hoangwe/Computation-design-fabrication-and-control-of-a-Two-wheel-Balancing-Robot./imgs/Circuit-diagram-of-two-wheel-self-balancing-robot-696x381.jpg

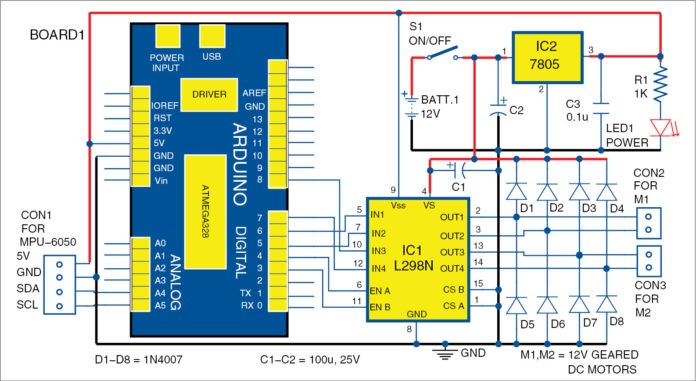
imgs/Circuit-diagram-of-two-wheel-self-balancing-robot-696x381.jpg
