hoangwe/Computation-design-fabrication-and-control-of-a-Two-wheel-Balancing-Robot./imgs/z3968502732451_e49155647b118cd0371b57f4b867cec1.jpg

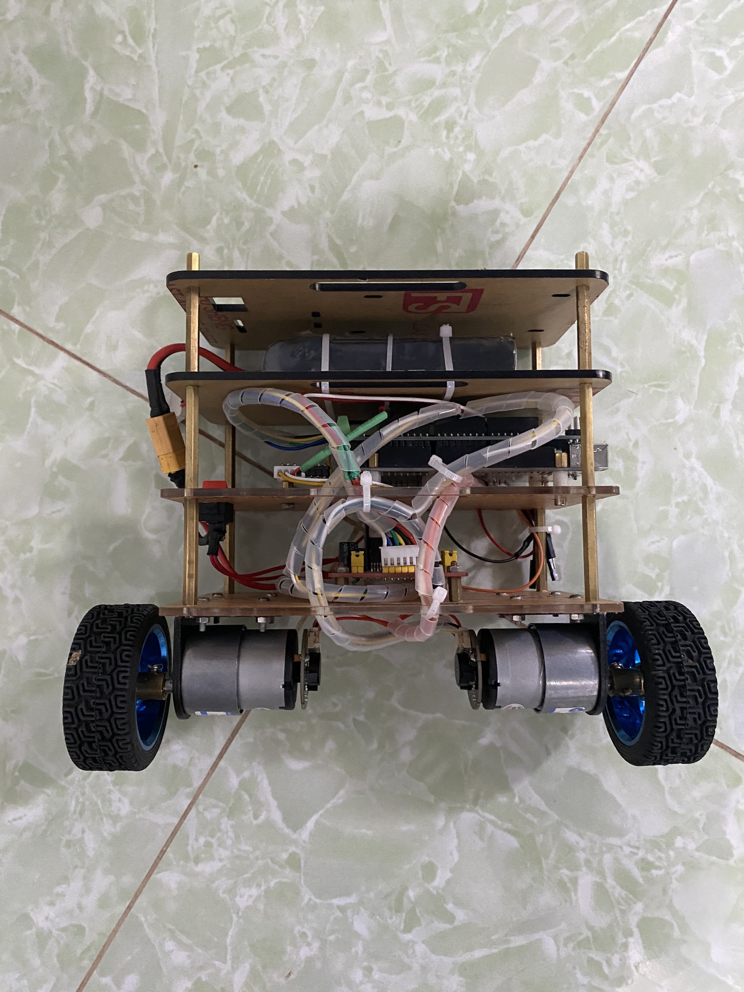
imgs/z3968502732451_e49155647b118cd0371b57f4b867cec1.jpg
