hoangwe/Computation-design-fabrication-and-control-of-a-Two-wheel-Balancing-Robot./README.md

# Computation-design-fabrication-and-control-of-a-Two-wheel-Balancing-Robot.
In this project, the system is developed for balancing and moving to the specified position. Real-time monitored and controlled system including GUI for observation, trajectory planning, and control quality assessment.
