hoangwe/Computation-design-fabrication-and-control-of-a-Two-wheel-Balancing-Robot./configurable-rc-coupling-1.snapshot.7/RC coupling - Camera 2 - Brass - 3 Point faded.JPG

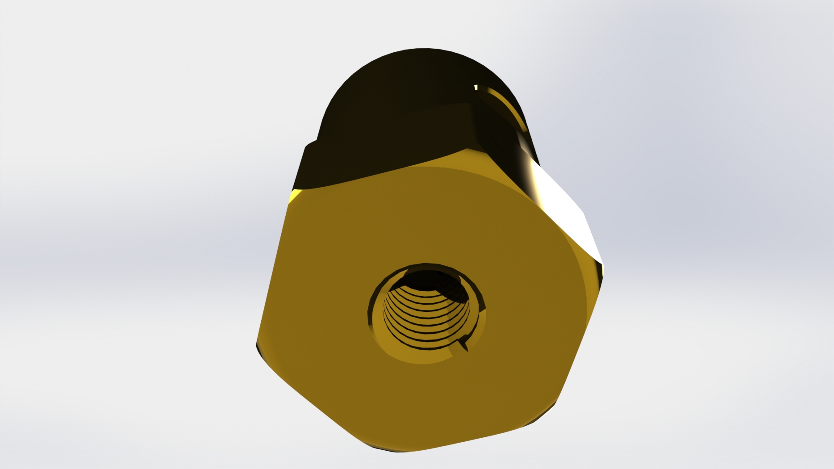
configurable-rc-coupling-1.snapshot.7/RC coupling - Camera 2 - Brass - 3 Point faded.JPG
