hoangwe/Computation-design-fabrication-and-control-of-a-Two-wheel-Balancing-Robot./imgs/anim2.gif

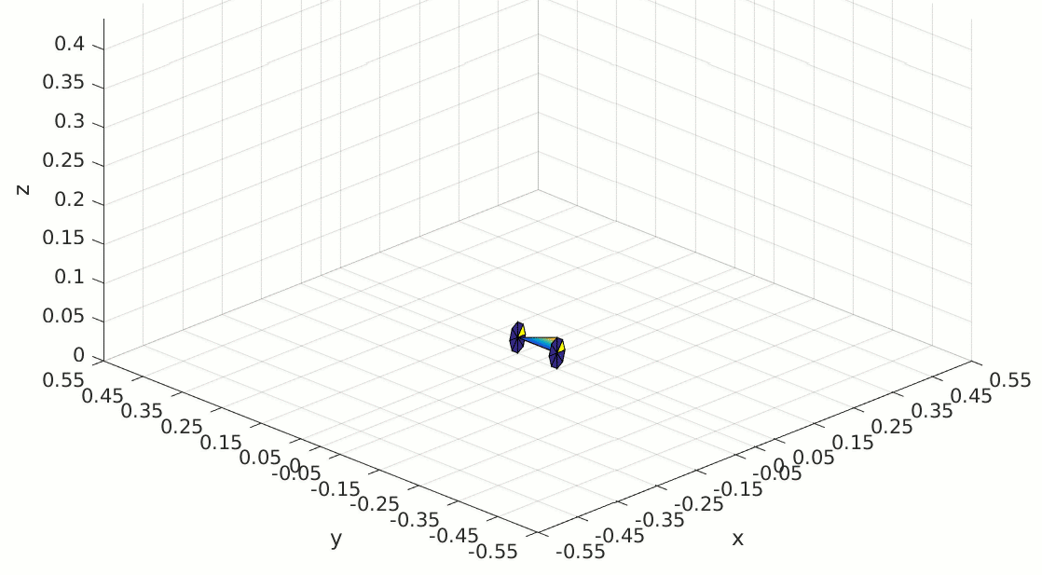
imgs/anim2.gif
