hoangwe/Computation-design-fabrication-and-control-of-a-Two-wheel-Balancing-Robot./imgs/BalanceCarRobot_PCB-V06_01.jpg

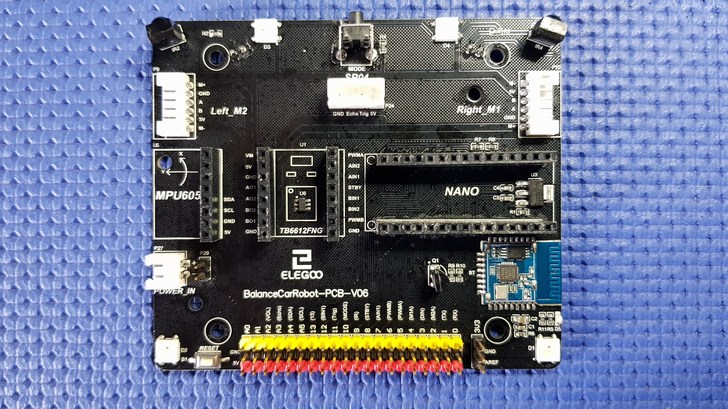
imgs/BalanceCarRobot_PCB-V06_01.jpg
