hoangwe/Computation-design-fabrication-and-control-of-a-Two-wheel-Balancing-Robot./imgs/plot1.png

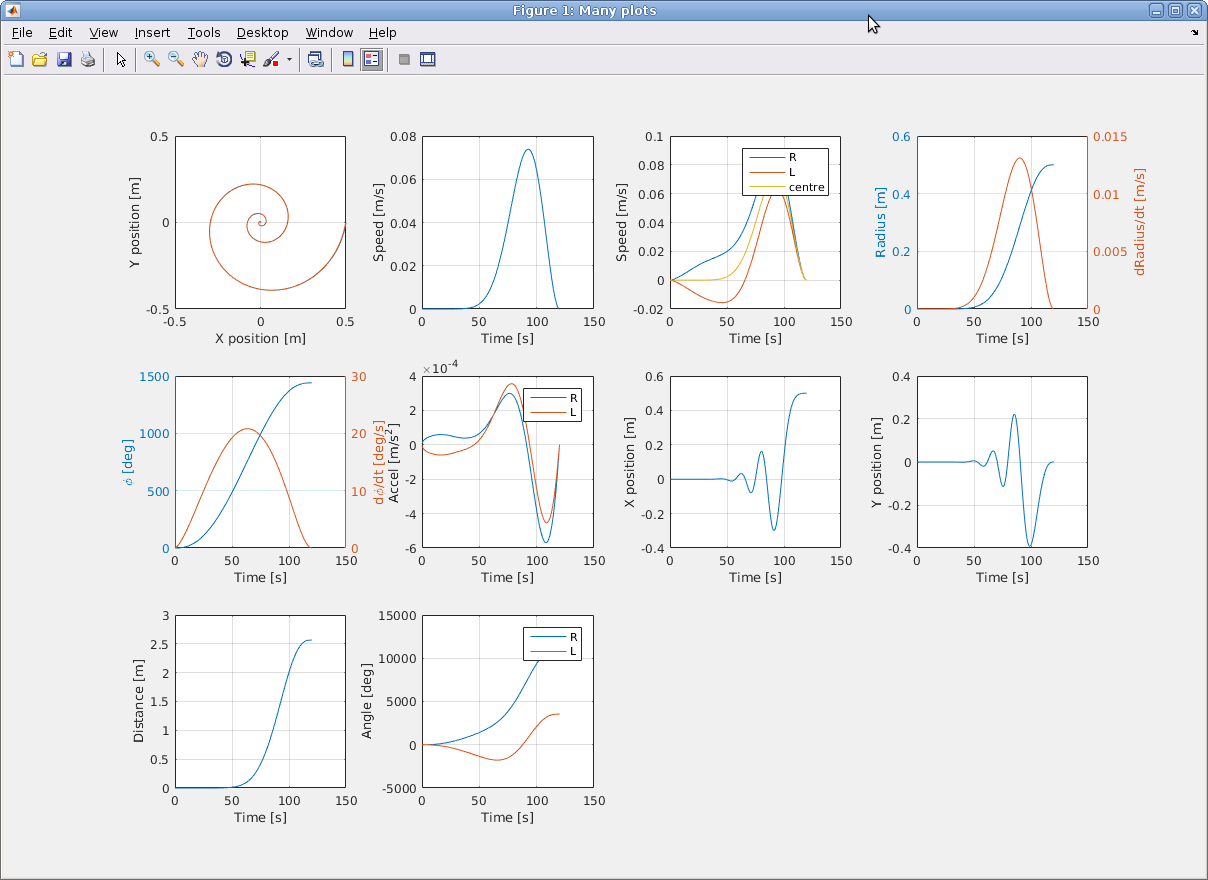
imgs/plot1.png
