hoangwe/Computation-design-fabrication-and-control-of-a-Two-wheel-Balancing-Robot./New folder/e_drawing/electric-images/0001.jpg

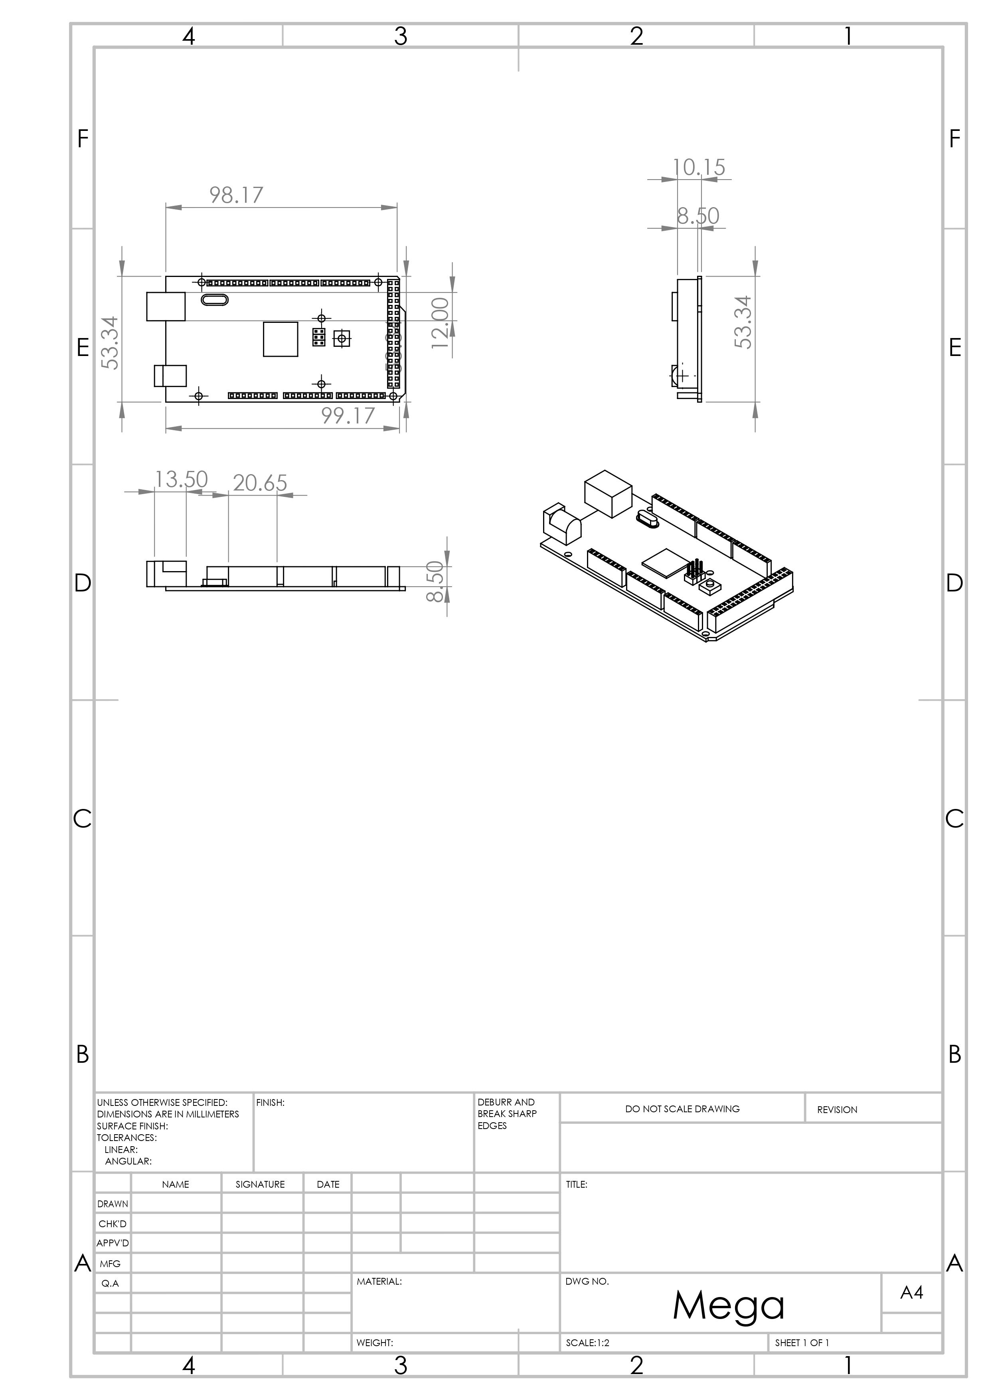
New folder/e_drawing/electric-images/0001.jpg
