hoangwe/Computation-design-fabrication-and-control-of-a-Two-wheel-Balancing-Robot./New folder/New folder/encoder.jpg

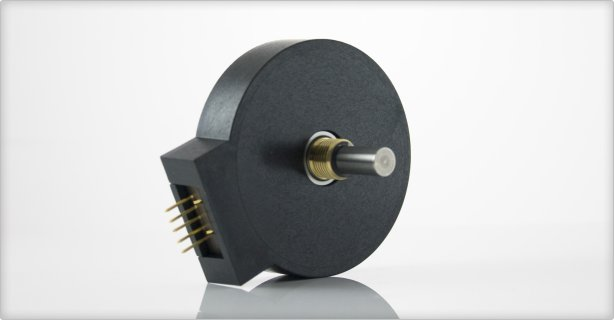
New folder/New folder/encoder.jpg
