hoangwe/Computation-design-fabrication-and-control-of-a-Two-wheel-Balancing-Robot./New folder/New folder/L298N_v2-removebg-preview.png

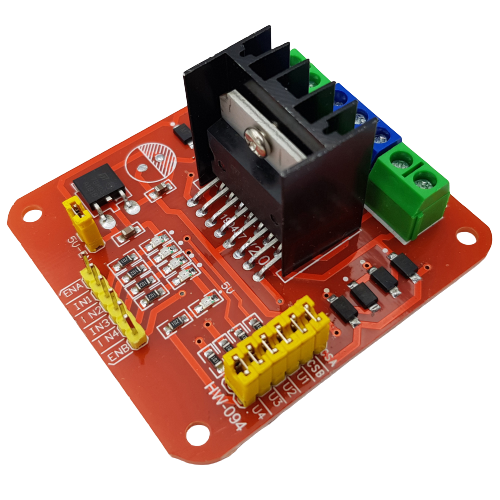
New folder/New folder/L298N_v2-removebg-preview.png
