hoangwe/Computation-design-fabrication-and-control-of-a-Two-wheel-Balancing-Robot./New folder/New folder/Mo_hinh.JPG

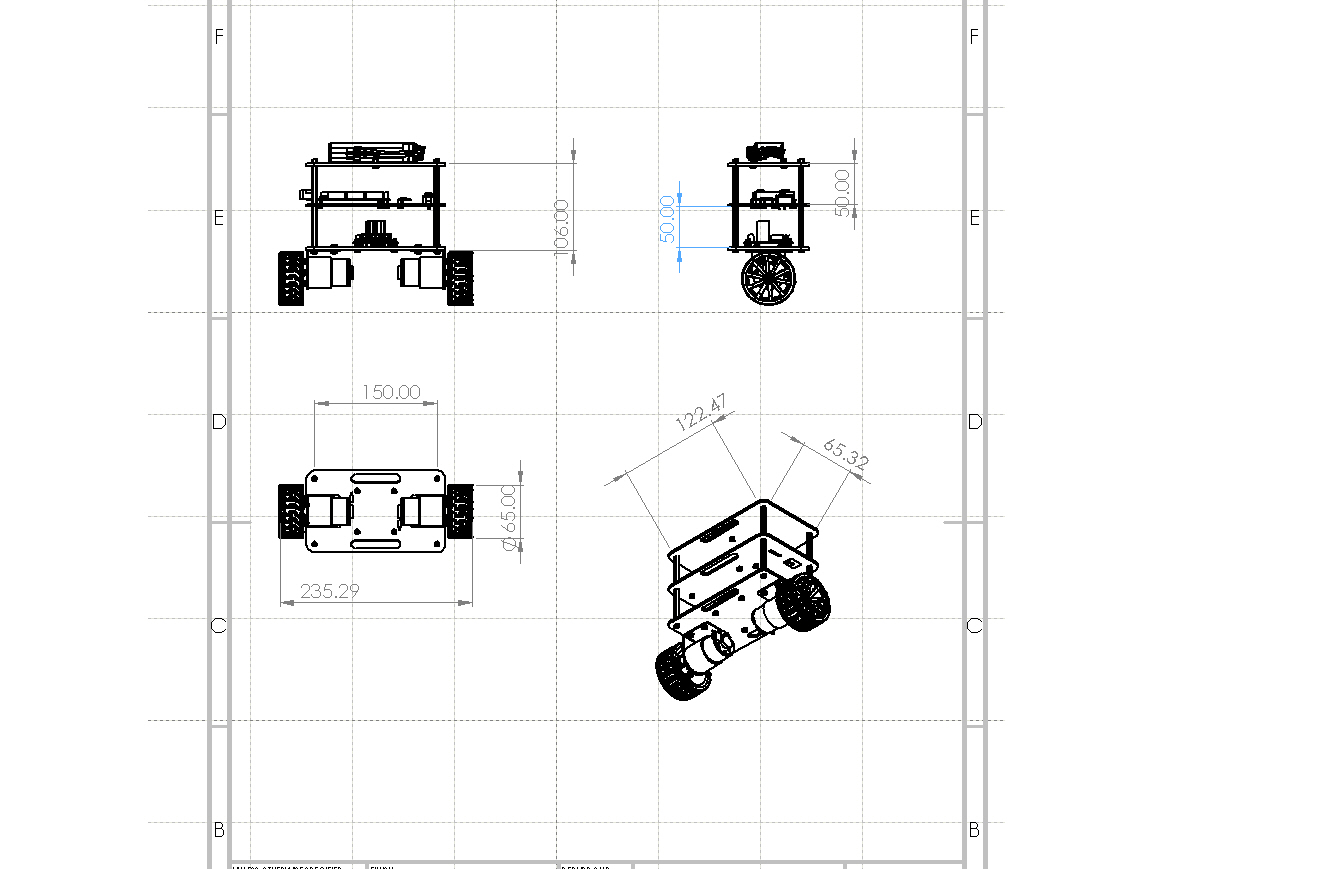
New folder/New folder/Mo_hinh.JPG
