hoangwe/Computation-design-fabrication-and-control-of-a-Two-wheel-Balancing-Robot./New folder/New folder/mohinh.jpg

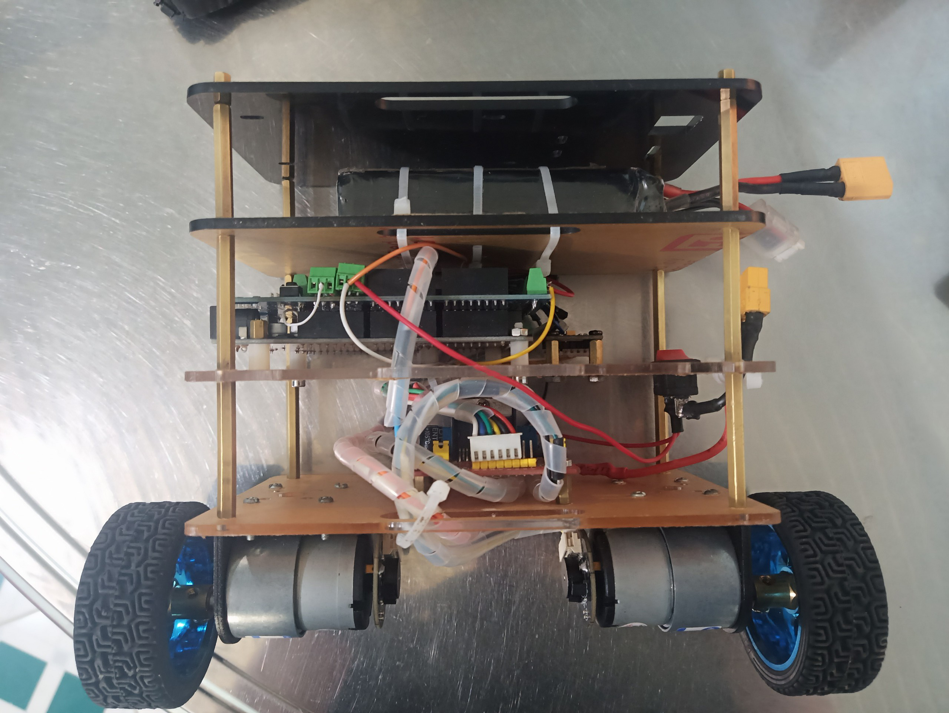
New folder/New folder/mohinh.jpg
