hoangwe/Computation-design-fabrication-and-control-of-a-Two-wheel-Balancing-Robot./New folder/New folder/mohinh_v2-removebg-preview.png

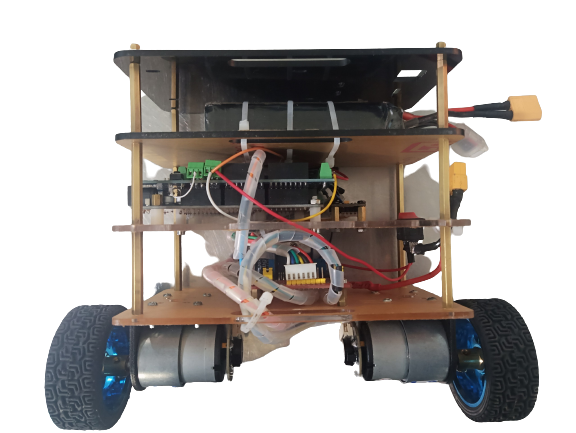
New folder/New folder/mohinh_v2-removebg-preview.png
