hoangwe/Computation-design-fabrication-and-control-of-a-Two-wheel-Balancing-Robot./New folder/New folder/New folder/New folder/file_dwg/37 mm DC Geared Motor Mounting Bracket.jpg

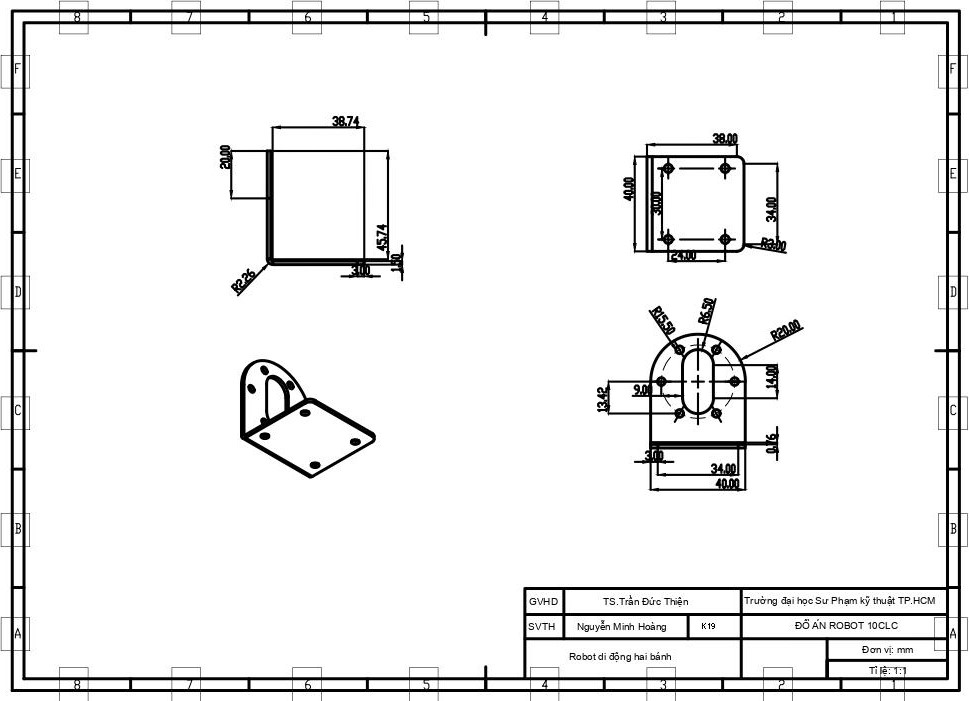
New folder/New folder/New folder/New folder/file_dwg/37 mm DC Geared Motor Mounting Bracket.jpg
