hoangwe/Computation-design-fabrication-and-control-of-a-Two-wheel-Balancing-Robot./New folder/New folder/New folder/New folder/file_dwg/Part0_loc.jpg

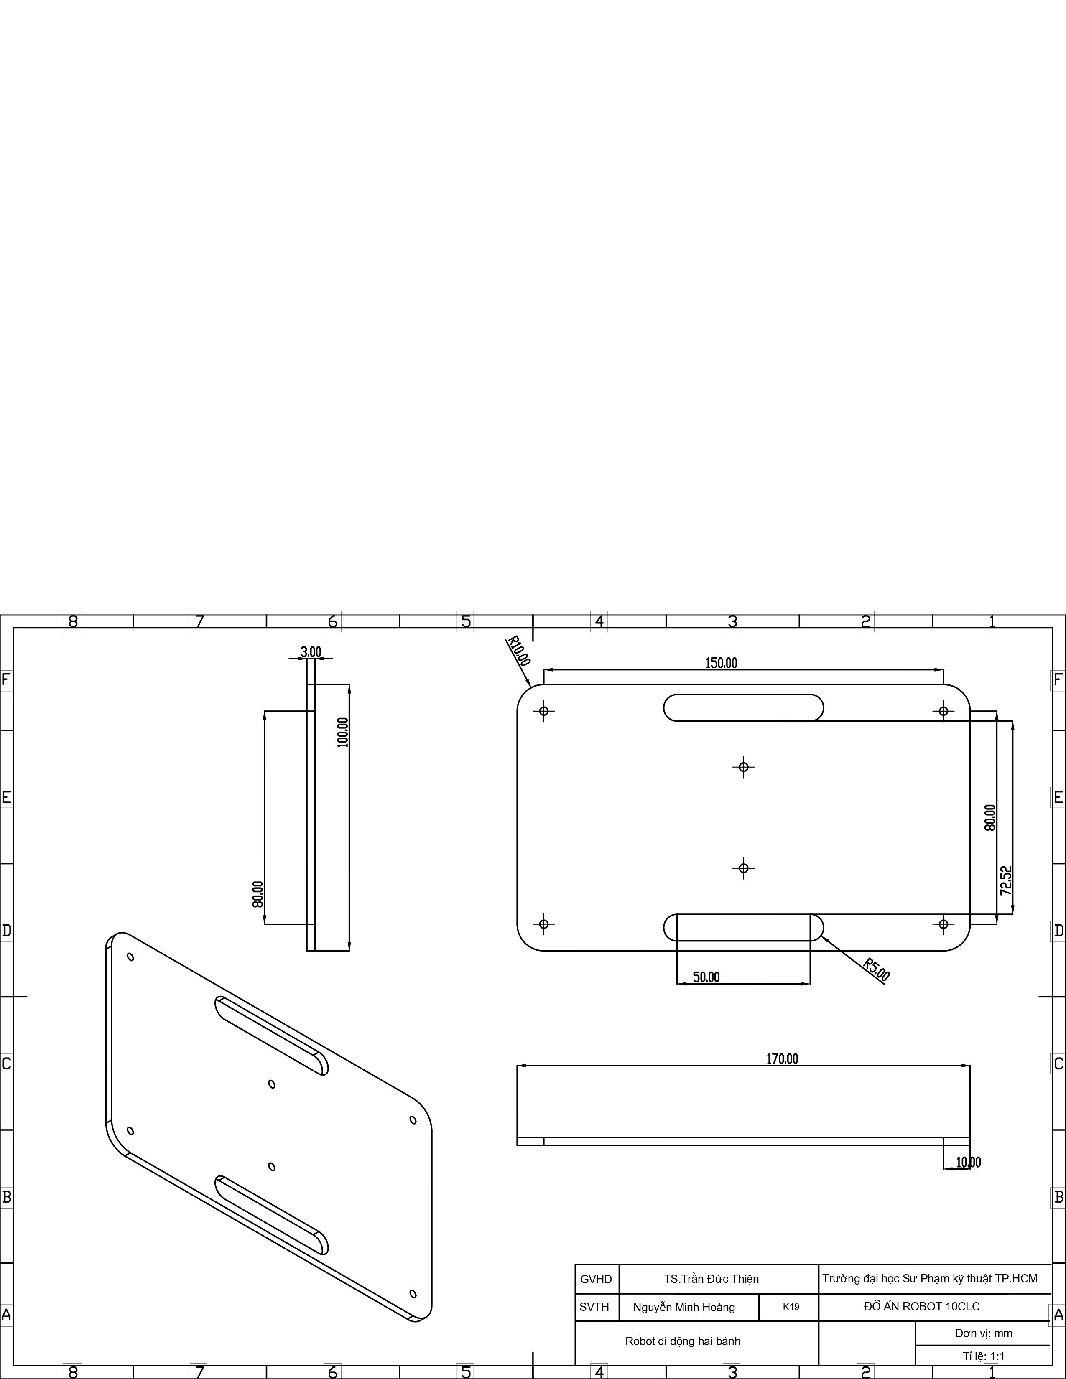
New folder/New folder/New folder/New folder/file_dwg/Part0_loc.jpg
