hoangwe/Computation-design-fabrication-and-control-of-a-Two-wheel-Balancing-Robot./New folder/New folder/New folder/New folder/file_dwg/Part3_loc_v2.jpg

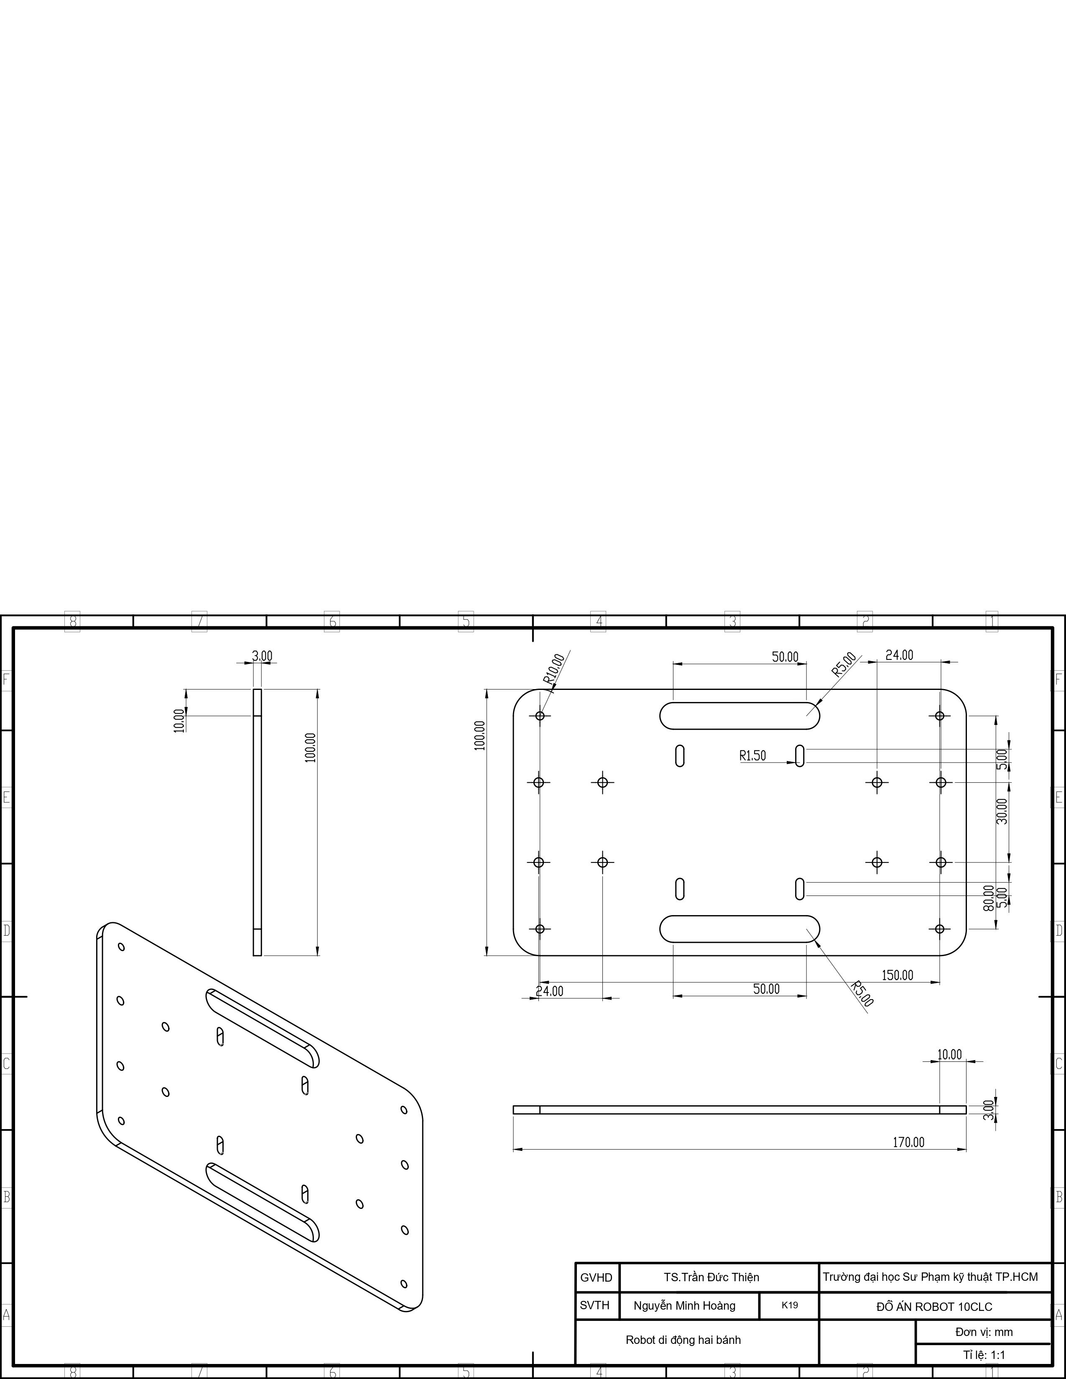
New folder/New folder/New folder/New folder/file_dwg/Part3_loc_v2.jpg
