hoangwe/Computation-design-fabrication-and-control-of-a-Two-wheel-Balancing-Robot./New folder/New folder/Part0_loc.jpg

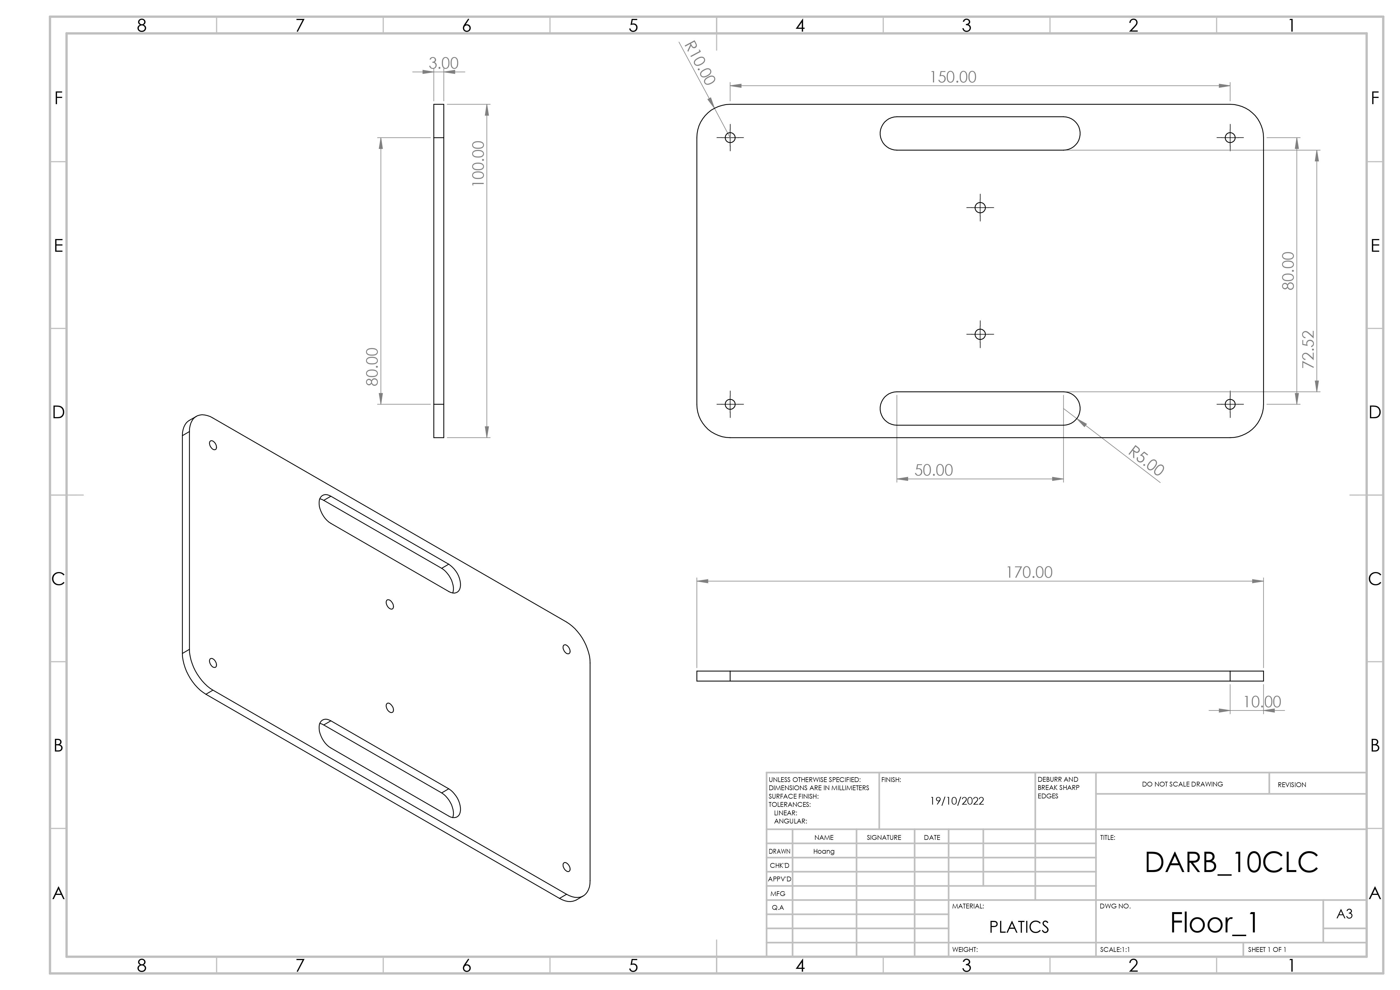
New folder/New folder/Part0_loc.jpg
