hoangwe/Computation-design-fabrication-and-control-of-a-Two-wheel-Balancing-Robot./New folder/New folder/Part3_loc.jpg

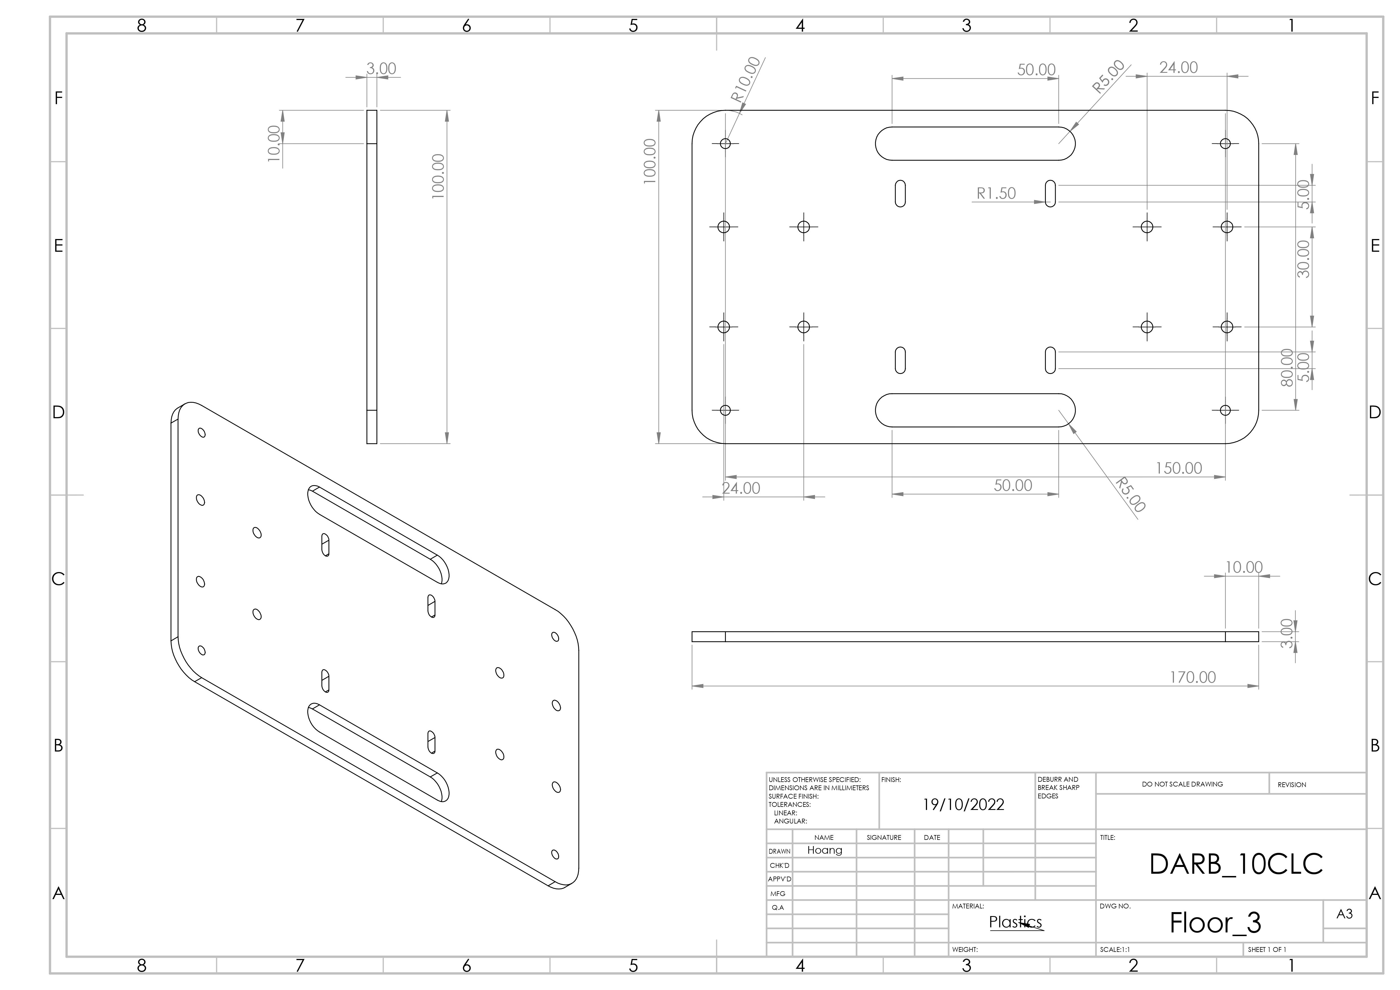
New folder/New folder/Part3_loc.jpg
