hoangwe/Computation-design-fabrication-and-control-of-a-Two-wheel-Balancing-Robot./New folder/New folder/zigbee-removebg-preview.png

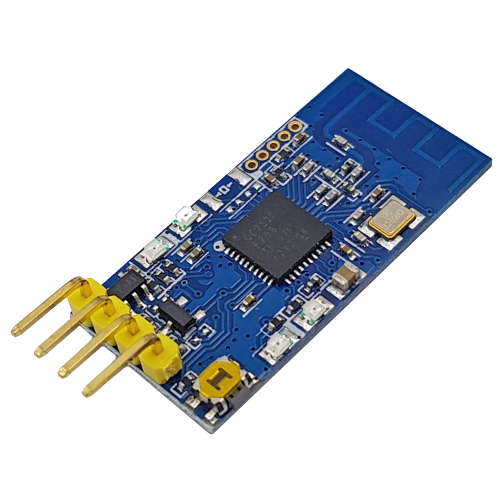
New folder/New folder/zigbee-removebg-preview.png
