hoangwe/Computation-design-fabrication-and-control-of-a-Two-wheel-Balancing-Robot./New folder/tattu-1800mah-4s-lipo-battery-1.snapshot.3/TATTU 1800mah 4s.SLDASM

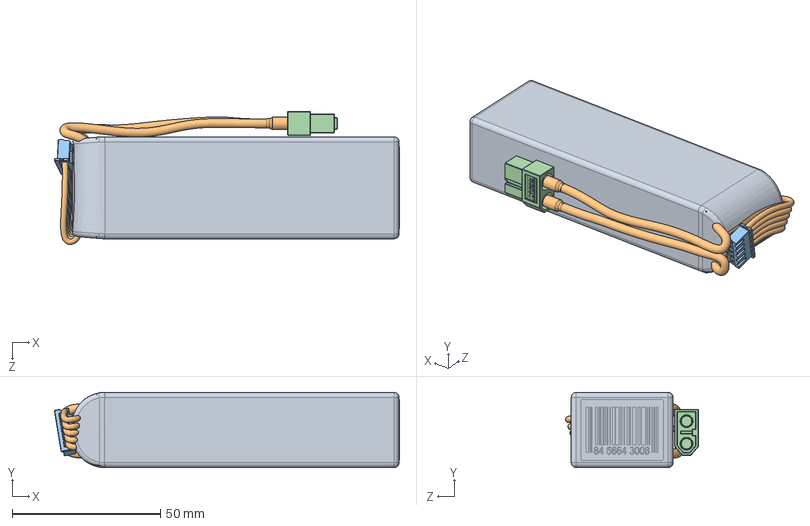
[picture p196: CAD file, 2023-08-06]
New folder/tattu-1800mah-4s-lipo-battery-1.snapshot.3/TATTU 1800mah 4s.SLDASM
116.3 x 25.4 x 44.8 mm
FUNDA
NUCLEO
JST XHP-4
XT60 Buchse
