hoangwe/Computation-design-fabrication-and-control-of-a-Two-wheel-Balancing-Robot./Floor_1.SLDASM

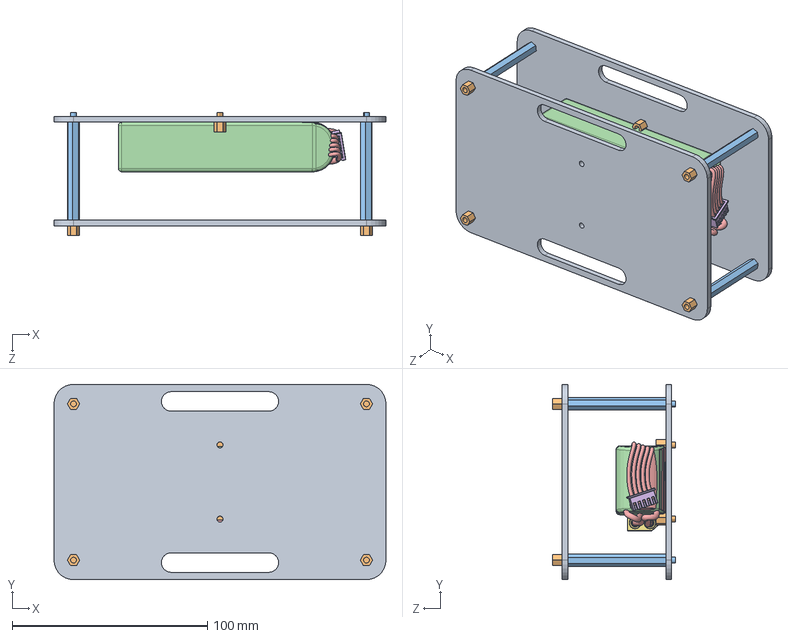
[picture p197: CAD file, 2023-08-06]
Floor_1.SLDASM
170.0 x 100.0 x 63.0 mm
Part0_loc x 2
Tru dong M3 - 5mm_Default_sldprt.step x 6
Tru dong M3 - 35mm_Default_sldprt.step x 4
NUCLEO
JST XHP-4
XT60 Buchse
