hoangwe/Computation-design-fabrication-and-control-of-a-Two-wheel-Balancing-Robot./Floor_2.SLDASM

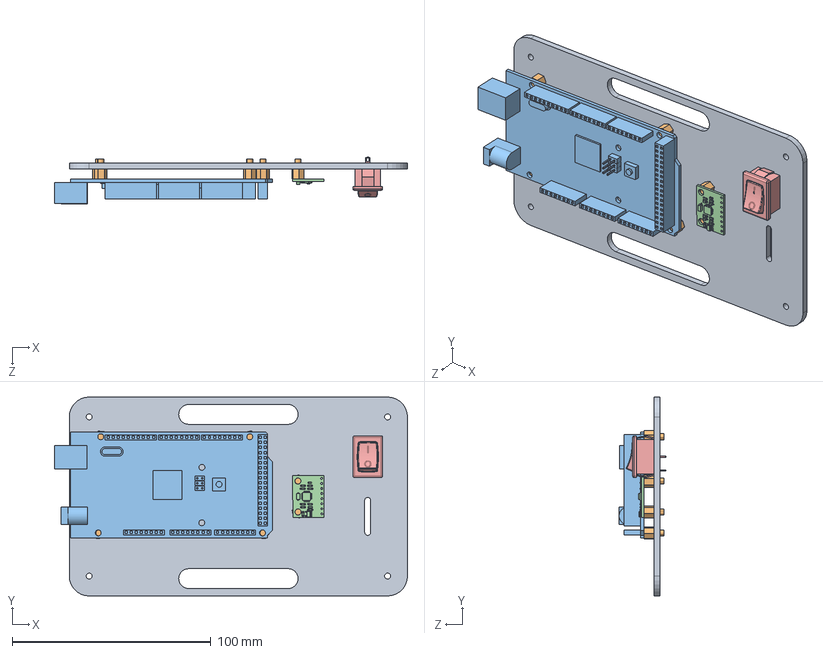
[picture p198: CAD file, 2023-08-06]
Floor_2.SLDASM
177.4 x 100.0 x 23.5 mm
Tru dong M3 - 5mm_Default_sldprt.step x 6
Mega
MPU60503
switch
