hoangwe/Computation-design-fabrication-and-control-of-a-Two-wheel-Balancing-Robot./wheel.SLDASM

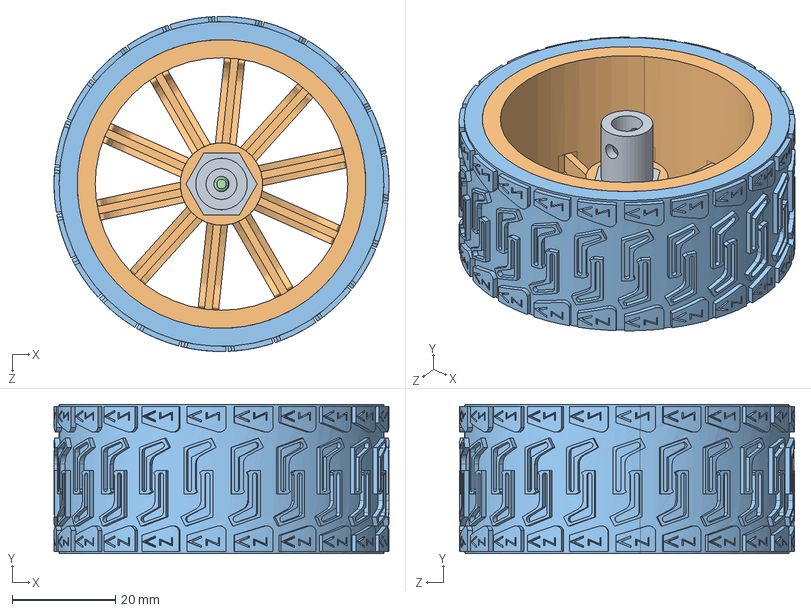
[picture p199: CAD file, 2023-08-06]
wheel.SLDASM
65.0 x 29.0 x 65.0 mm
motor_shaft_coupling_v3
blue_wheel_frame_Default_sldprt.step
65mm tire_Default_sldprt.step
M3 x 0.5mm Thread 3mm
