hoangwe/Computation-design-fabrication-and-control-of-a-Two-wheel-Balancing-Robot./configurable-rc-coupling-1.snapshot.7/Conversions/RC coupling.STEP

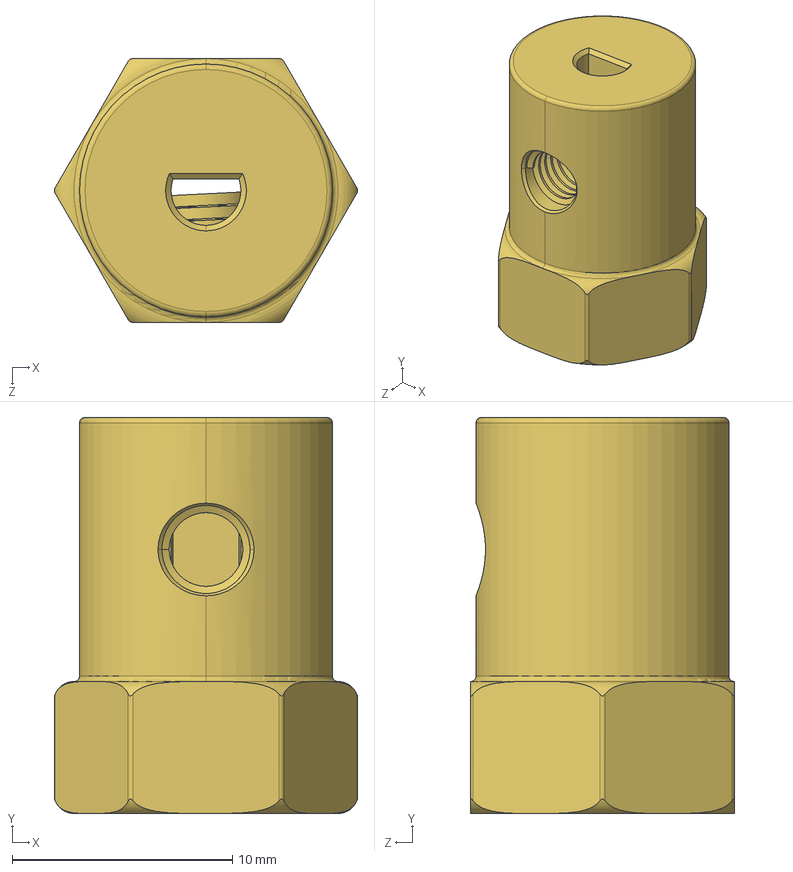
[picture p200: CAD file, 2023-08-06]
configurable-rc-coupling-1.snapshot.7/Conversions/RC coupling.STEP
13.8 x 18.0 x 12.0 mm
