hoangwe/Computation-design-fabrication-and-control-of-a-Two-wheel-Balancing-Robot./New folder/37-mm-dc-geared-motor-mounting-bracket-1.snapshot.11/37 mm DC Geared Motor Mounting Bracket.STEP

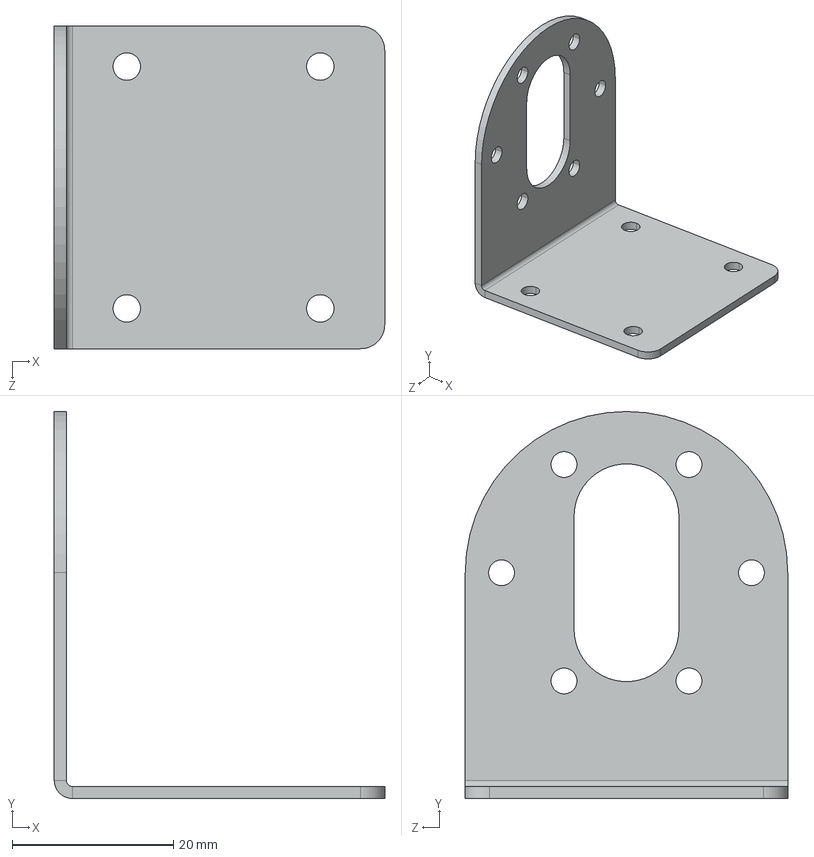
[picture p201: CAD file, 2023-08-06]
New folder/37-mm-dc-geared-motor-mounting-bracket-1.snapshot.11/37 mm DC Geared Motor Mounting Bracket.STEP
41.0 x 48.0 x 40.0 mm
