hoangwe/Computation-design-fabrication-and-control-of-a-Two-wheel-Balancing-Robot./Part1_loc.SLDPRT

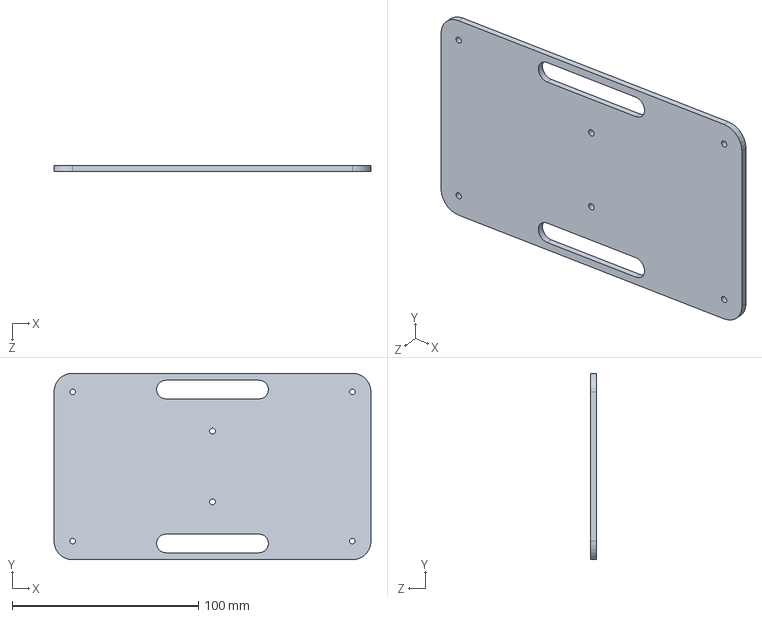
[picture p204: CAD file, 2023-08-06]
Part1_loc.SLDPRT
170.0 x 100.0 x 3.00 mm
