hoangwe/Computation-design-fabrication-and-control-of-a-Two-wheel-Balancing-Robot./M3 x 0.5mm Thread 3mm.SLDPRT

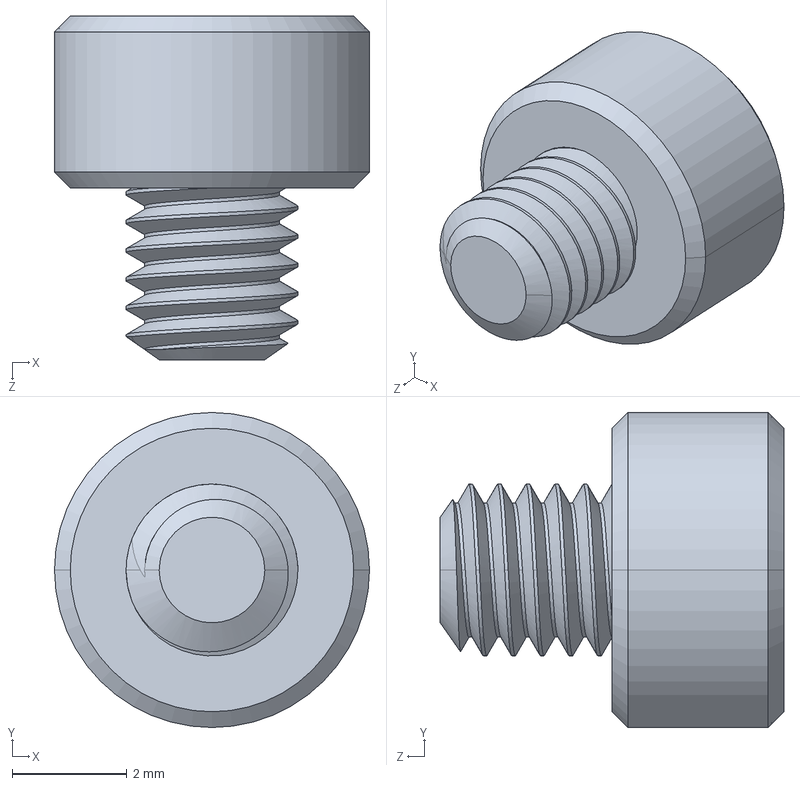
[picture p205: CAD file, 2023-08-06]
M3 x 0.5mm Thread 3mm.SLDPRT
5.50 x 5.50 x 6.00 mm
