hoangwe/Computation-design-fabrication-and-control-of-a-Two-wheel-Balancing-Robot./New folder/arduino-mega-case-3d-printed-1.snapshot.3/arduino_mega_top.stl

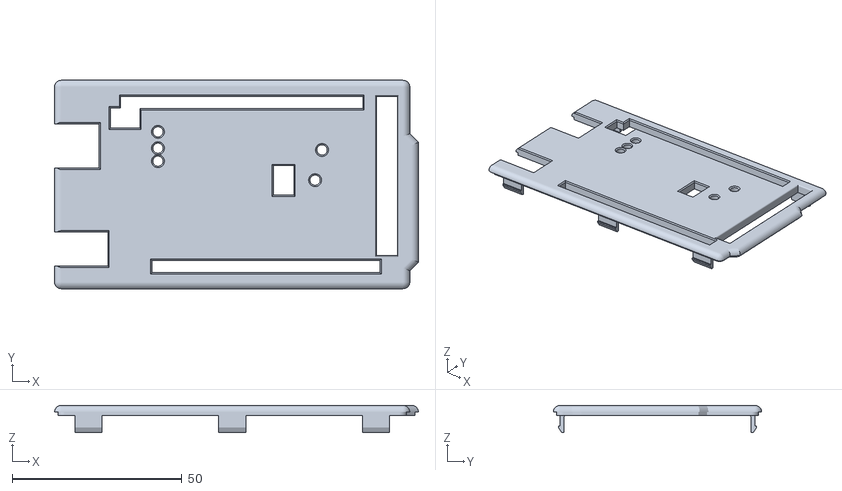
[picture p206: CAD file, 2023-08-06]
New folder/arduino-mega-case-3d-printed-1.snapshot.3/arduino_mega_top.stl
107.1 x 61.3 x 8.00
