hoangwe/Computation-design-fabrication-and-control-of-a-Two-wheel-Balancing-Robot./New folder/tattu-1800mah-4s-lipo-battery-1.snapshot.3/TATTU 1800mah 4s/TATTU 1800mah 4s/Nueva carpeta/XT60 Buchse.SLDPRT

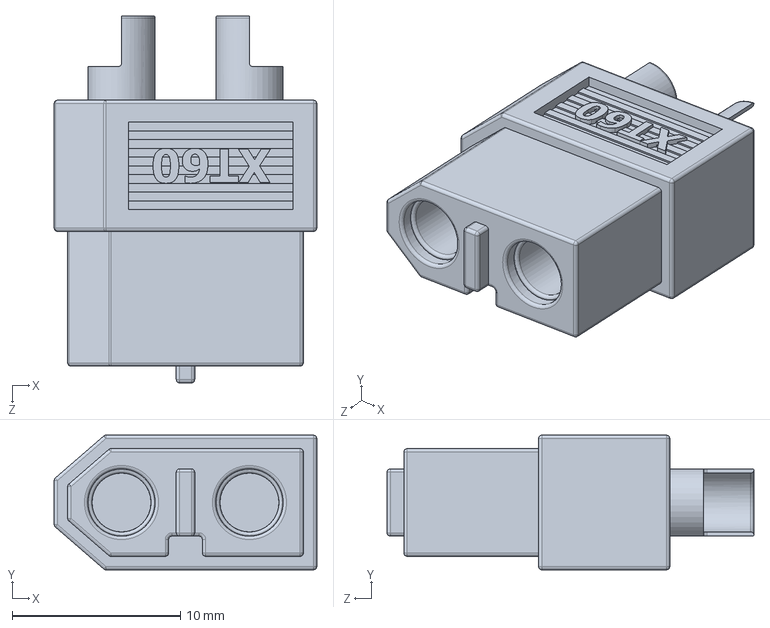
[picture p208: CAD file, 2023-08-06]
New folder/tattu-1800mah-4s-lipo-battery-1.snapshot.3/TATTU 1800mah 4s/TATTU 1800mah 4s/Nueva carpeta/XT60 Buchse.SLDPRT
15.6 x 8.00 x 21.8 mm
