hoangwe/Computation-design-fabrication-and-control-of-a-Two-wheel-Balancing-Robot./New folder/arduino-mega-case-3d-printed-1.snapshot.3/Mega.STEP

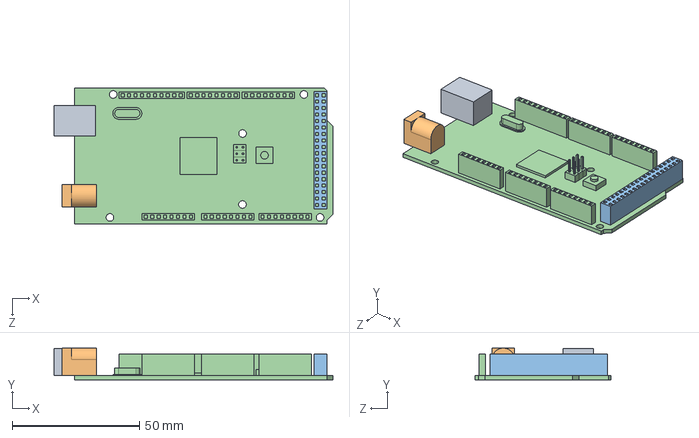
[picture p209: CAD file, 2023-08-06]
New folder/arduino-mega-case-3d-printed-1.snapshot.3/Mega.STEP
109.6 x 12.5 x 53.3 mm
