hoangwe/Computation-design-fabrication-and-control-of-a-Two-wheel-Balancing-Robot./New folder/bringsmart-jga25-371-12v-dc-geared-motor-with-encoder-collection-1.snapshot.3/Export/STEP/JGA25-371_12VDC_23RPM.stp

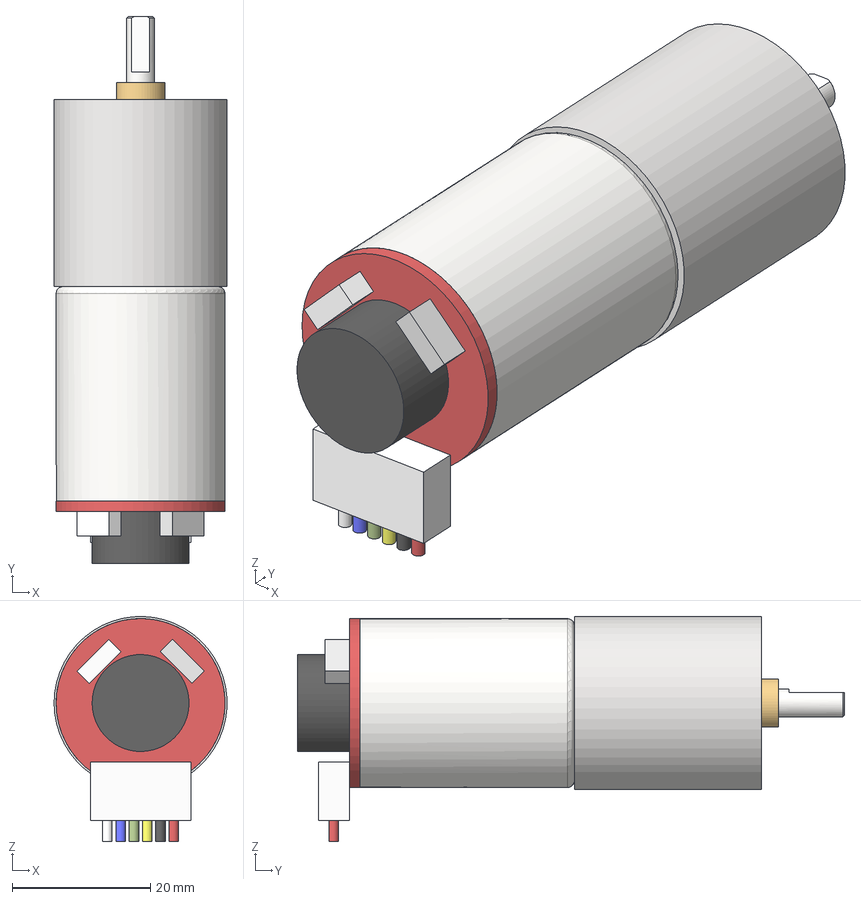
[picture p210: CAD file, 2023-08-06]
New folder/bringsmart-jga25-371-12v-dc-geared-motor-with-encoder-collection-1.snapshot.3/Export/STEP/JGA25-371_12VDC_23RPM.stp
25.0 x 79.0 x 32.5 mm
