hoangwe/Computation-design-fabrication-and-control-of-a-Two-wheel-Balancing-Robot./New folder/tattu-1800mah-4s-lipo-battery-1.snapshot.3/TATTU 1800mah 4s/TATTU 1800mah 4s/Nueva carpeta/JST XHP-4.sldprt

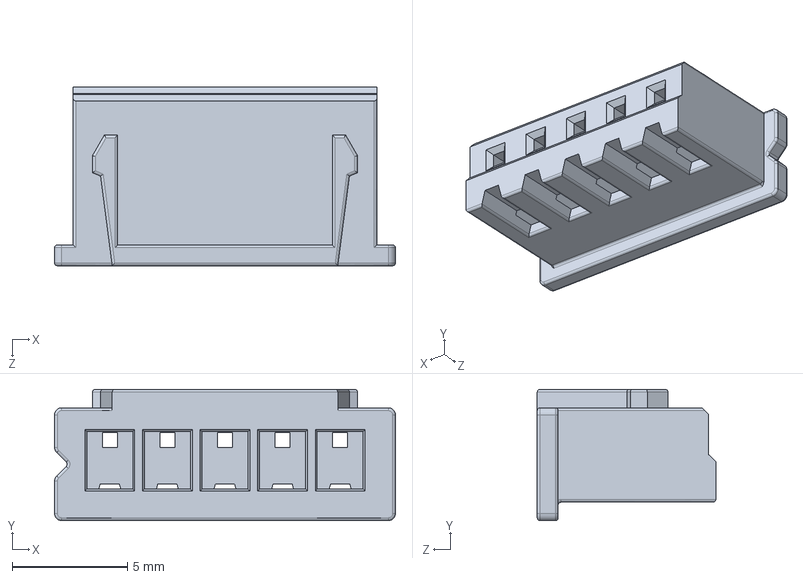
[picture p211: CAD file, 2023-08-06]
New folder/tattu-1800mah-4s-lipo-battery-1.snapshot.3/TATTU 1800mah 4s/TATTU 1800mah 4s/Nueva carpeta/JST XHP-4.sldprt
14.8 x 5.70 x 7.75 mm
