hoangwe/Computation-design-fabrication-and-control-of-a-Two-wheel-Balancing-Robot./Part12.SLDPRT

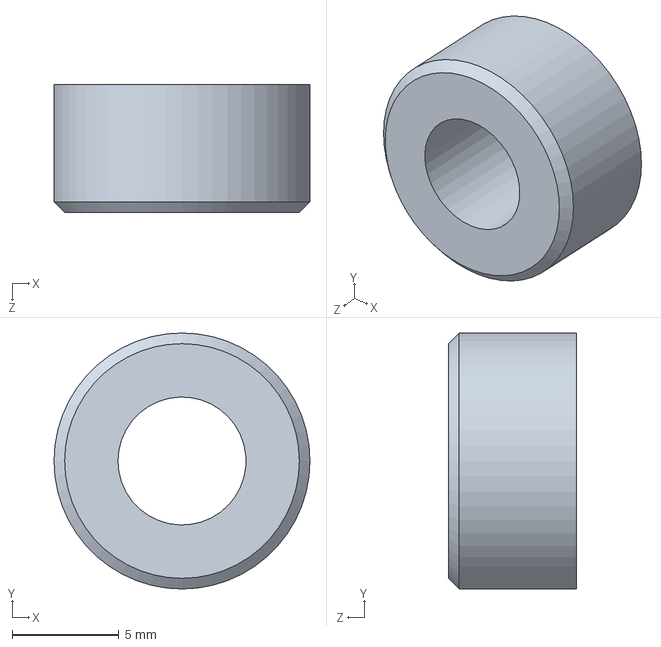
[picture p212: CAD file, 2023-08-06]
Part12.SLDPRT
12.0 x 12.0 x 6.00 mm
