hoangwe/Computation-design-fabrication-and-control-of-a-Two-wheel-Balancing-Robot./New folder/New folder/37 mm DC Geared Motor Mounting Bracket.DXF

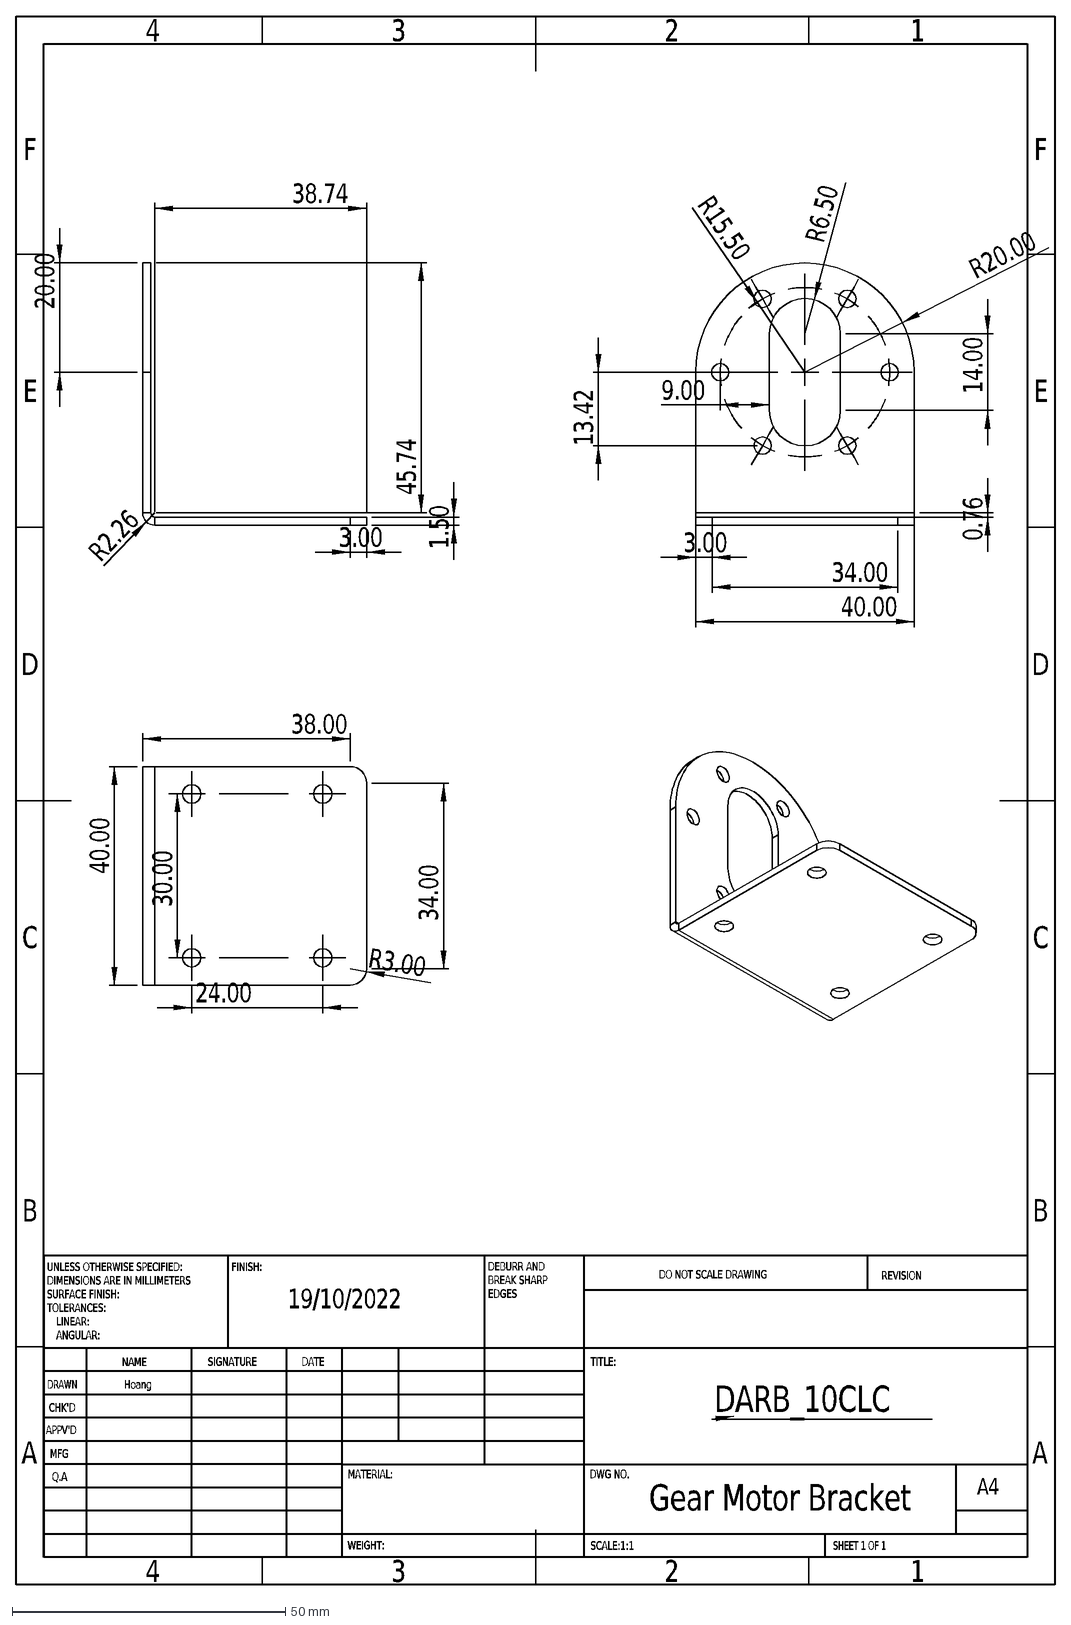
[picture p214: CAD file, 2023-08-06]
New folder/New folder/37 mm DC Geared Motor Mounting Bracket.DXF
A
B
C
D
E
F
4
3
2
1
DRAWN
CHK'D
APPV'D
MFG
Q.A
UNLESS OTHERWISE SPECIFIED:
DIMENSIONS ARE IN MILLIMETERS
SURFACE FINISH:
TOLERANCES:
LINEAR:
ANGULAR:
FINISH:
DEBURR AND
BREAK SHARP
EDGES
NAME
SIGNATURE
DATE
MATERIAL:
DO NOT SCALE DRAWING
REVISION
TITLE:
DWG NO.
SCALE:1:1
SHEET 1 OF 1
A4
WEIGHT:
Hoang
Gear Motor Bracket
DARB_10CLC
19/10/2022
38.74
45.74
3.00
1.50
R2.26
20.00
14.00
R6.50
R20.00
34.00
40.00
0.76
9.00
13.42
R15.50
24.00
R3.00
38.00
30.00
