hoangwe/Computation-design-fabrication-and-control-of-a-Two-wheel-Balancing-Robot./New folder/tattu-1800mah-4s-lipo-battery-1.snapshot.3/TATTU 1800mah 4s/TATTU 1800mah 4s/Nueva carpeta/FUNDA.SLDPRT

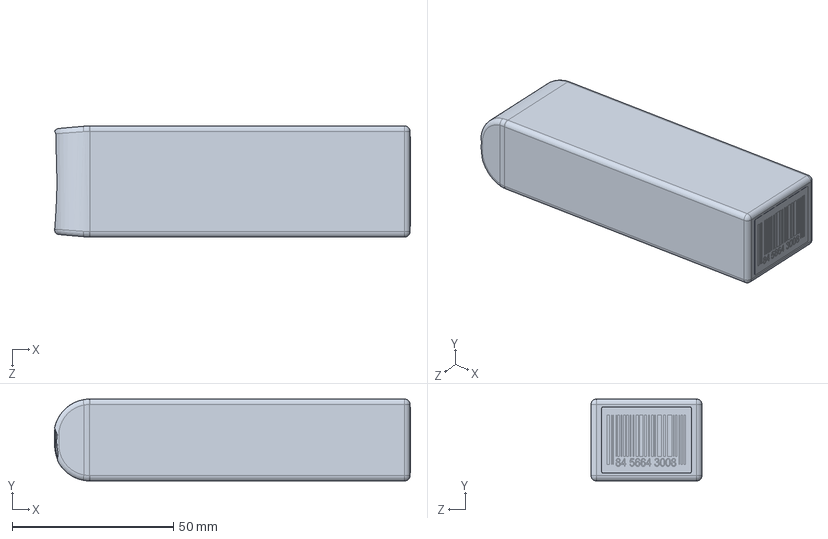
[picture p215: CAD file, 2023-08-06]
New folder/tattu-1800mah-4s-lipo-battery-1.snapshot.3/TATTU 1800mah 4s/TATTU 1800mah 4s/Nueva carpeta/FUNDA.SLDPRT
110.3 x 25.4 x 34.4 mm
