hoangwe/Computation-design-fabrication-and-control-of-a-Two-wheel-Balancing-Robot./New folder/tattu-1800mah-4s-lipo-battery-1.snapshot.3/TATTU 1800mah 4s/TATTU 1800mah 4s/Nueva carpeta/NUCLEO.SLDPRT

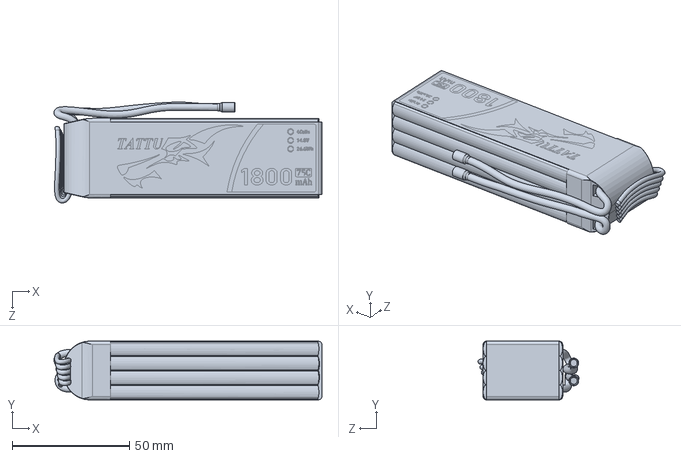
[picture p217: CAD file, 2023-08-06]
New folder/tattu-1800mah-4s-lipo-battery-1.snapshot.3/TATTU 1800mah 4s/TATTU 1800mah 4s/Nueva carpeta/NUCLEO.SLDPRT
114.2 x 25.0 x 43.0 mm
