hoangwe/Computation-design-fabrication-and-control-of-a-Two-wheel-Balancing-Robot./switch_Default_sldprt.STEP

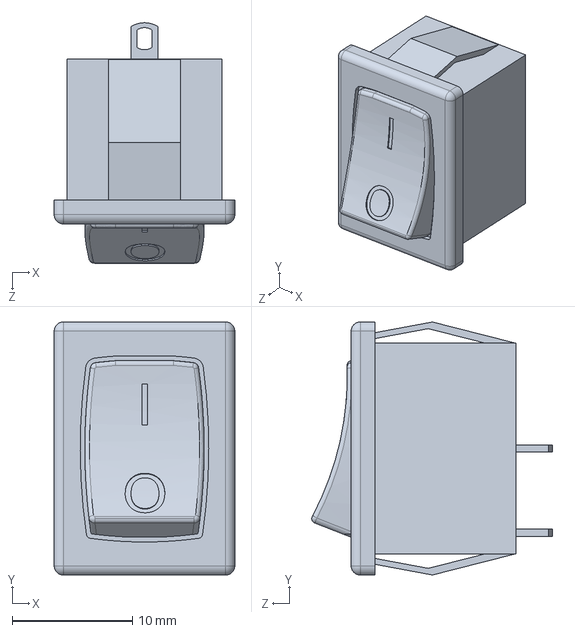
[picture p218: CAD file, 2023-08-06]
switch_Default_sldprt.STEP
15.0 x 21.0 x 20.0 mm
