hoangwe/Computation-design-fabrication-and-control-of-a-Two-wheel-Balancing-Robot./Part2_v2.SLDPRT

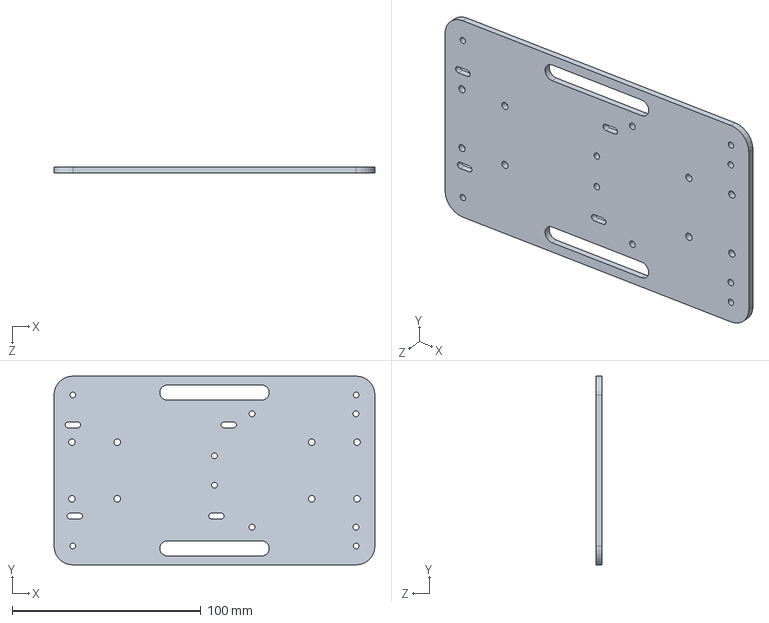
[picture p220: CAD file, 2023-08-06]
Part2_v2.SLDPRT
170.0 x 100.0 x 3.00 mm
