hoangwe/Computation-design-fabrication-and-control-of-a-Two-wheel-Balancing-Robot./MOTOR SHAFT- JGB37-520-1_Default_sldprt.STEP

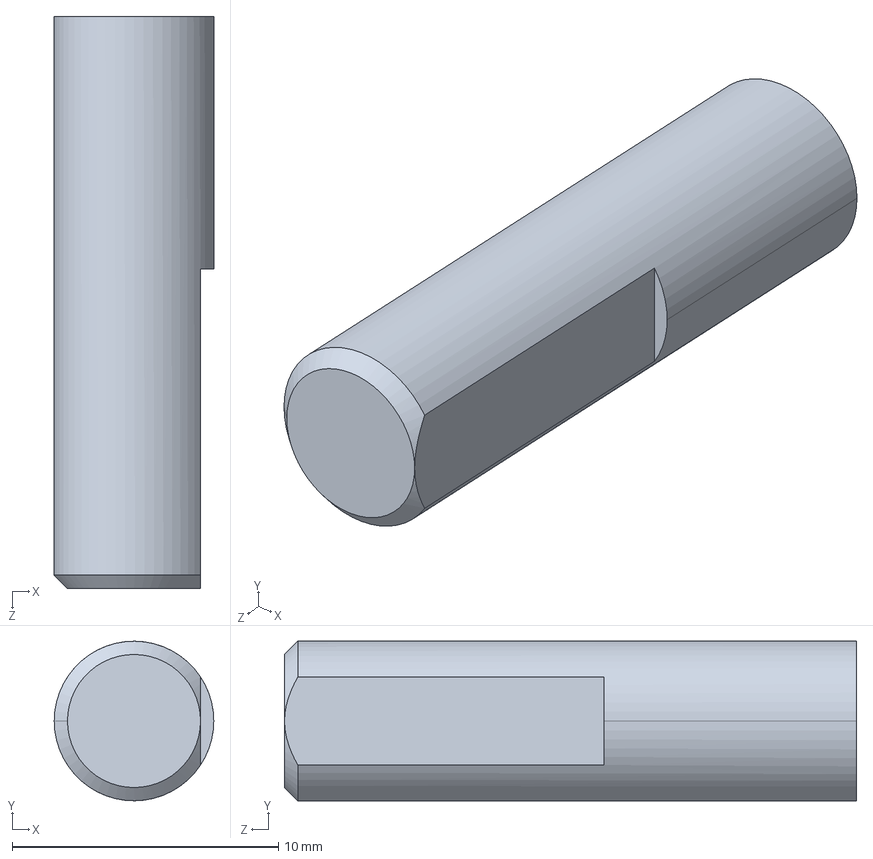
[picture p221: CAD file, 2023-08-06]
MOTOR SHAFT- JGB37-520-1_Default_sldprt.STEP
6.00 x 6.00 x 21.5 mm
