hoangwe/Computation-design-fabrication-and-control-of-a-Two-wheel-Balancing-Robot./DC MOTOR- JGB37-520-1_Default_sldprt.STEP

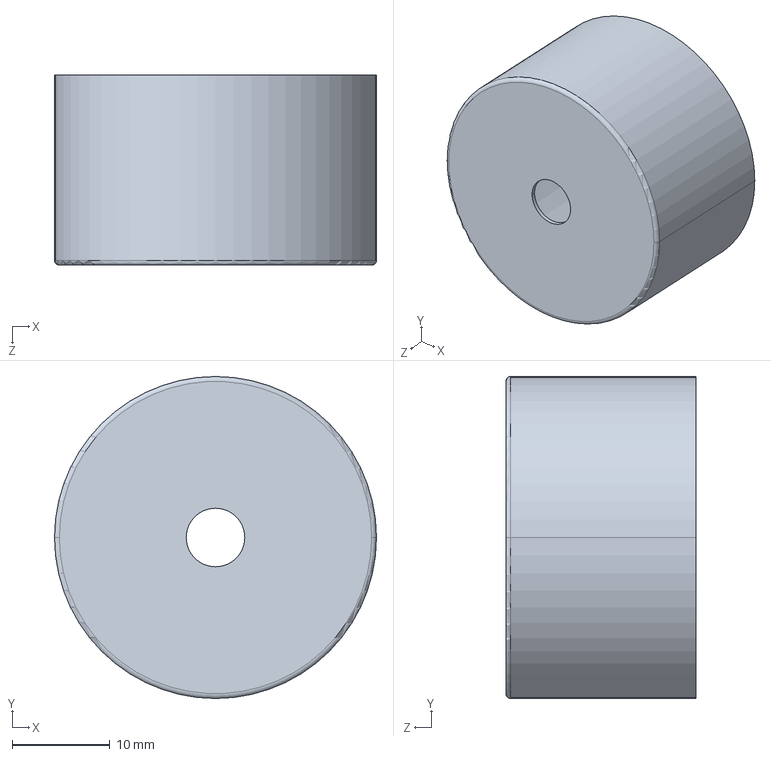
[picture p222: CAD file, 2023-08-06]
DC MOTOR- JGB37-520-1_Default_sldprt.STEP
33.0 x 33.0 x 19.5 mm
