hoangwe/Computation-design-fabrication-and-control-of-a-Two-wheel-Balancing-Robot./l298.SLDPRT

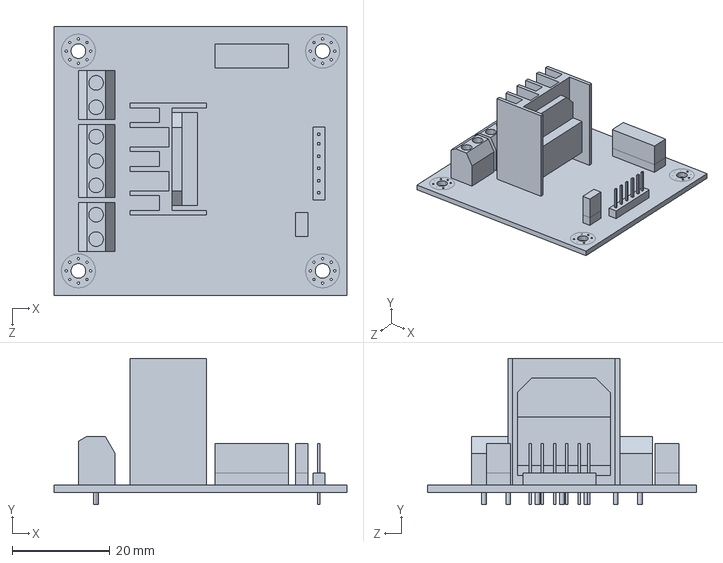
[picture p223: CAD file, 2023-08-06]
l298.SLDPRT
60.0 x 30.0 x 55.0 mm
