hoangwe/Computation-design-fabrication-and-control-of-a-Two-wheel-Balancing-Robot./Tru dong M3 - 5mm_Default_sldprt.step.SLDPRT

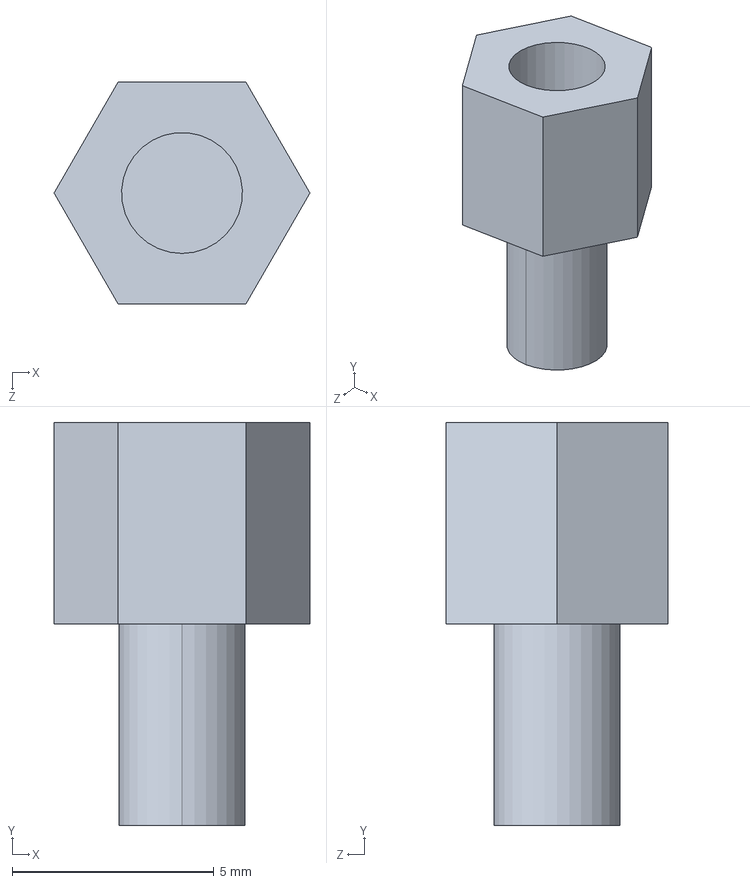
[picture p224: CAD file, 2023-08-06]
Tru dong M3 - 5mm_Default_sldprt.step.SLDPRT
6.35 x 10.0 x 5.50 mm
