hoangwe/Computation-design-fabrication-and-control-of-a-Two-wheel-Balancing-Robot./blue_wheel_frame_Default_sldprt.step_Default_sldprt.STEP

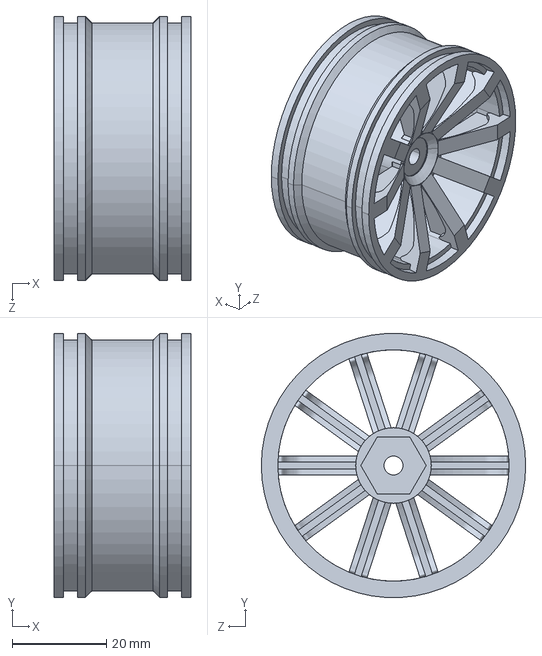
[picture p225: CAD file, 2023-08-06]
blue_wheel_frame_Default_sldprt.step_Default_sldprt.STEP
29.0 x 55.9 x 56.0 mm
