hoangwe/Computation-design-fabrication-and-control-of-a-Two-wheel-Balancing-Robot./Tru dong M3 - 35mm_Default_sldprt.step_Default_sldprt.STEP

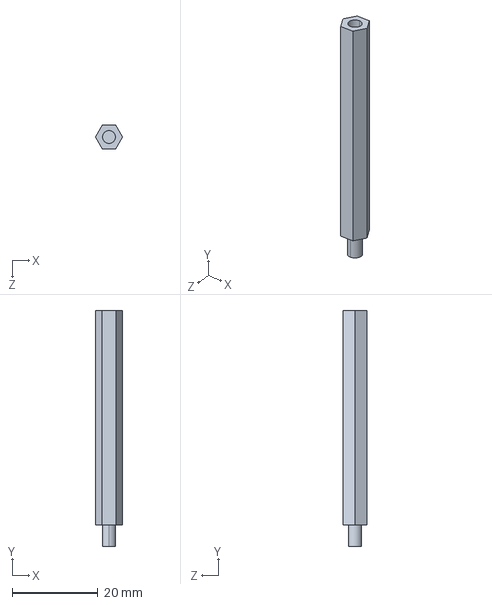
[picture p226: CAD file, 2023-08-06]
Tru dong M3 - 35mm_Default_sldprt.step_Default_sldprt.STEP
6.35 x 55.0 x 5.50 mm
