hoangwe/Computation-design-fabrication-and-control-of-a-Two-wheel-Balancing-Robot./PLASTIC COVER- DC MOTOR- JGB37-520-1_Default_sldprt.STEP

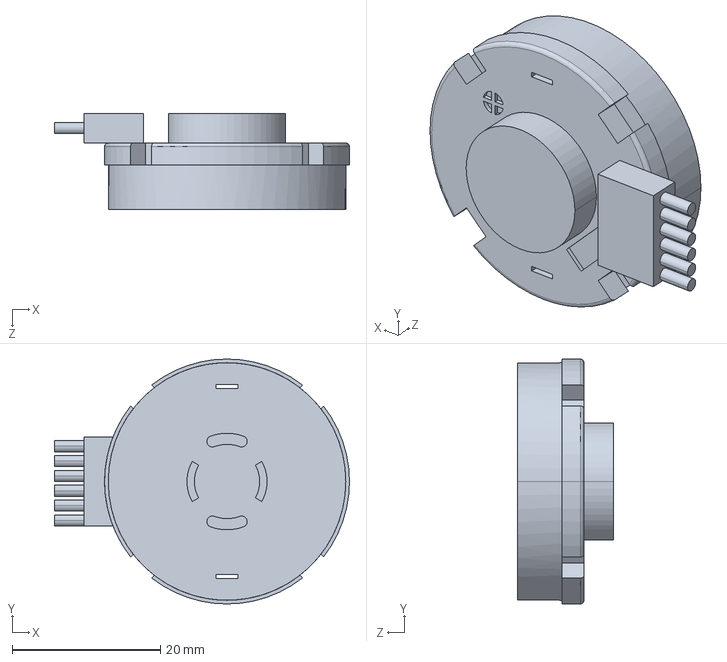
[picture p227: CAD file, 2023-08-06]
PLASTIC COVER- DC MOTOR- JGB37-520-1_Default_sldprt.STEP
39.7 x 33.0 x 13.0 mm
