hoangwe/Computation-design-fabrication-and-control-of-a-Two-wheel-Balancing-Robot./COUPLING BRACKET- GEARED BODY TO DC MOTOR- JGB37-520-1_Default_sldprt.STEP

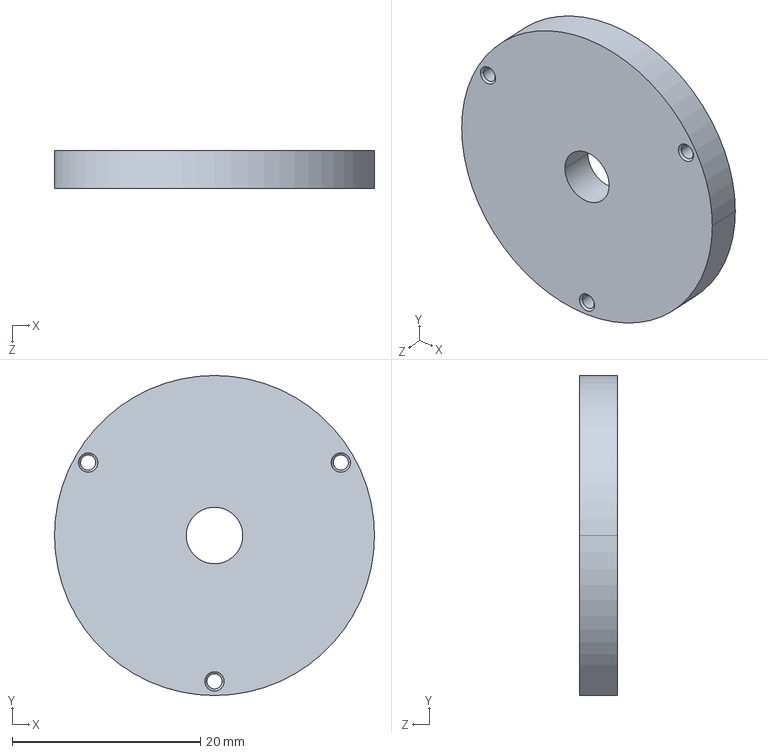
[picture p228: CAD file, 2023-08-06]
COUPLING BRACKET- GEARED BODY TO DC MOTOR- JGB37-520-1_Default_sldprt.STEP
34.0 x 34.0 x 4.00 mm
