hoangwe/Computation-design-fabrication-and-control-of-a-Two-wheel-Balancing-Robot./motor_shaft_coupling.SLDPRT

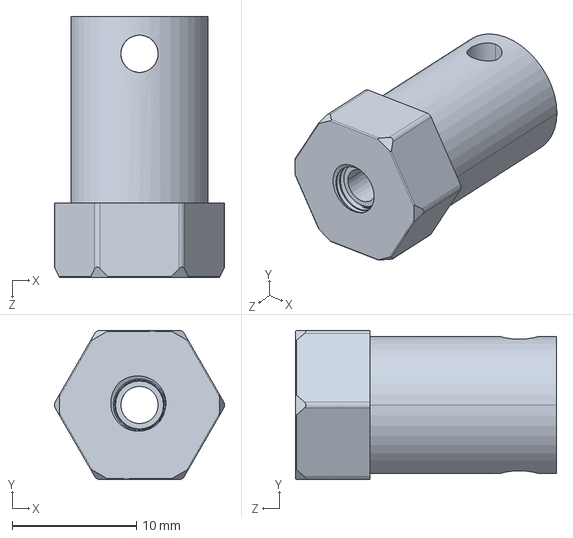
[picture p229: CAD file, 2023-08-06]
motor_shaft_coupling.SLDPRT
13.7 x 12.0 x 21.0 mm
