hoangwe/Computation-design-fabrication-and-control-of-a-Two-wheel-Balancing-Robot./GEARED BODY- MOTOR- JGB37-520-1_Default_sldprt.STEP

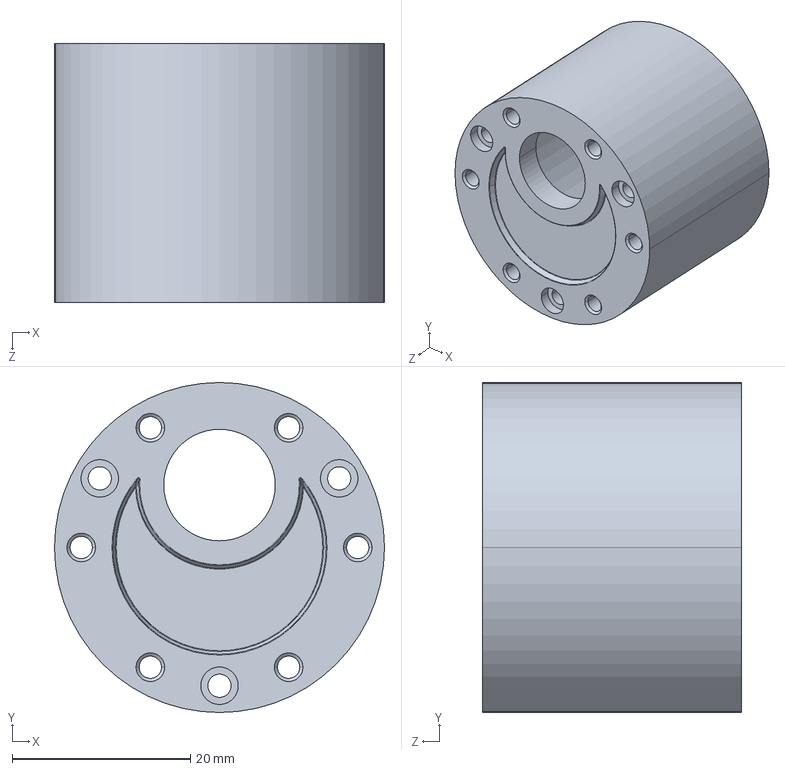
[picture p230: CAD file, 2023-08-06]
GEARED BODY- MOTOR- JGB37-520-1_Default_sldprt.STEP
37.0 x 37.0 x 29.0 mm
