hoangwe/Computation-design-fabrication-and-control-of-a-Two-wheel-Balancing-Robot./pan cross head_am(B18.6.7M - M2 x 0.4 x 25 Type I Cross Recessed PHMS --25N)_Default_sldprt.STEP

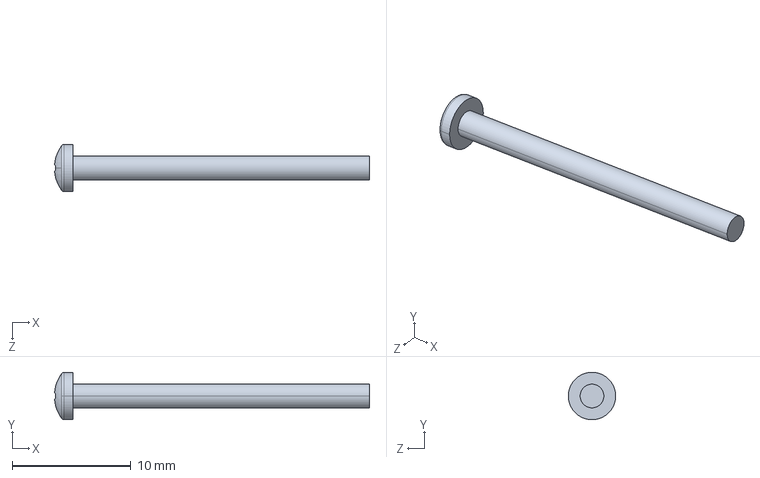
[picture p231: CAD file, 2023-08-06]
pan cross head_am(B18.6.7M - M2 x 0.4 x 25 Type I Cross Recessed PHMS --25N)_Default_sldprt.STEP
26.6 x 4.00 x 4.00 mm
