hoangwe/Computation-design-fabrication-and-control-of-a-Two-wheel-Balancing-Robot./(list of files, cad)

Other CAD files:
New folder/tattu-1800mah-4s-lipo-battery-1.snapshot.3/TATTU 1800mah 4s/TATTU 1800mah 4s/TATTU 1800mah 4s.SLDASM
New folder/New folder/New folder/New folder/Part2_loc.DXF
New folder/New folder/Part3_loc.DXF
New folder/tattu-1800mah-4s-lipo-battery-1.snapshot.3/TATTU 1800mah 4s/TATTU 1800mah 4s/Nueva carpeta/LOGO.SLDPRT
New folder/New folder/New folder/New folder/Part3_loc.DXF
New folder/New folder/Part2_loc.DXF
New folder/New folder/New folder/New folder/Part0_loc.DXF
New folder/New folder/Part0_loc.DXF
New folder/bringsmart-jga25-371-12v-dc-geared-motor-with-encoder-collection-1.snapshot.3/Export/STEP/JGA25-371_12VDC_50RPM.stp
New folder/bringsmart-jga25-371-12v-dc-geared-motor-with-encoder-collection-1.snapshot.3/Export/STEP/JGA25-371_12VDC_85RPM.stp
FUNDA_Predeterminado_sldprt.STEP
New folder/bringsmart-jga25-371-12v-dc-geared-motor-with-encoder-collection-1.snapshot.3/Export/STEP/JGA25-371_12VDC_18RPM.stp
Part3_loc.SLDPRT
New folder/bringsmart-jga25-371-12v-dc-geared-motor-with-encoder-collection-1.snapshot.3/Export/STEP/JGA25-371_12VDC_915RPM.stp
New folder/bringsmart-jga25-371-12v-dc-geared-motor-with-encoder-collection-1.snapshot.3/Export/STEP/JGA25-371_12VDC_250RPM.stp
Part2_loc.SLDPRT
Part1_Default_sldprt.STEP
motor_shaft_coupling_v3.SLDPRT
Part9.SLDPRT
RC coupling.step-Solid Bodies1.SLDPRT
l298_Default_sldprt.step.SLDPRT
XT60 Buchse_Predeterminado_sldprt.STEP
Part3.SLDPRT
switch.SLDPRT
Part0_loc.SLDPRT
motor_shaft_coupling_v3_Default_sldprt.STEP
Tru dong M3 - 5mm_Default_sldprt.step_Default_sldprt.STEP
M3 x 0.5mm Thread 3mm_Default_sldprt.STEP
SHAFT COUPLER- JGB37-520-1_Default_sldprt.STEP
RC coupling.step.SLDPRT
Part2.SLDPRT
l298_Default_sldprt.STEP
Part3_Default_sldprt.STEP
blue_wheel.SLDPRT
Mega_Default_sldprt.STEP
JST XHP-4_Predeterminado_sldprt.STEP
NUCLEO_Predeterminado_sldprt.STEP
Part1.SLDPRT
Part2_Default_sldprt.STEP
Tru dong M3 - 35mm_Default_sldprt.step.SLDPRT
M3 NUT_Default_sldprt.step_Default_sldprt.STEP
M3 x 0.5mm Thread 3mm_v2LONG SOCKET HEAD CAP SCREW_Default_sldprt.STEP
M3 x 0.5mm Thread 8mm LONG SOCKET HEAD CAP SCREW.step_Default_sldprt.STEP
MPU60503.SLDPRT
MPU60503_Default_sldprt.STEP
New folder/37-mm-dc-geared-motor-mounting-bracket-1.snapshot.11/37 mm DC Geared Motor Mounting Bracket.SLDPRT
New folder/37-mm-dc-geared-motor-mounting-bracket-1.snapshot.11/37 mm DC Geared Motor Mounting Bracket.x_b
New folder/New folder/37 mm DC Geared Motor Mounting Bracket.DWG
New folder/New folder/37 mm DC Geared Motor Mounting Bracket.SLDDRW
New folder/New folder/New folder/New folder/37 mm DC Geared Motor Mounting Bracket.DWG
New folder/New folder/New folder/New folder/Part0_loc.DWG
New folder/New folder/New folder/New folder/Part2_loc.DWG
New folder/New folder/New folder/New folder/Part3_loc.DWG
New folder/New folder/New folder/New folder/file_dwg/37 mm DC Geared Motor Mounting Bracket.DWG
New folder/New folder/New folder/New folder/file_dwg/Part0_loc.DWG
New folder/New folder/New folder/New folder/file_dwg/Part2_loc.DWG
New folder/New folder/New folder/New folder/file_dwg/Part3_loc.DWG
New folder/New folder/New folder/New folder/file_dxf/Part0_loc.DXF
New folder/New folder/New folder/New folder/file_dxf/Part2_loc.DXF
New folder/New folder/New folder/New folder/file_dxf/Part3_loc.DXF
New folder/New folder/Part0_loc.DWG
New folder/New folder/Part0_loc.SLDDRW
New folder/New folder/Part2_loc.DWG
New folder/New folder/Part2_loc.SLDDRW
New folder/New folder/Part3_loc.DWG
New folder/New folder/Part3_loc.SLDDRW
New folder/arduino-mega-case-3d-printed-1.snapshot.3/Mega.SLDPRT
New folder/bringsmart-jga25-371-12v-dc-geared-motor-with-encoder-collection-1.snapshot.3/Export/IGES/JGA25-371_12VDC_110RPM.igs
New folder/bringsmart-jga25-371-12v-dc-geared-motor-with-encoder-collection-1.snapshot.3/Export/IGES/JGA25-371_12VDC_18RPM.igs
New folder/bringsmart-jga25-371-12v-dc-geared-motor-with-encoder-collection-1.snapshot.3/Export/IGES/JGA25-371_12VDC_190RPM.igs
New folder/bringsmart-jga25-371-12v-dc-geared-motor-with-encoder-collection-1.snapshot.3/Export/IGES/JGA25-371_12VDC_1930RPM.igs
New folder/bringsmart-jga25-371-12v-dc-geared-motor-with-encoder-collection-1.snapshot.3/Export/IGES/JGA25-371_12VDC_23RPM.igs
New folder/bringsmart-jga25-371-12v-dc-geared-motor-with-encoder-collection-1.snapshot.3/Export/IGES/JGA25-371_12VDC_250RPM.igs
New folder/bringsmart-jga25-371-12v-dc-geared-motor-with-encoder-collection-1.snapshot.3/Export/IGES/JGA25-371_12VDC_39RPM.igs
New folder/bringsmart-jga25-371-12v-dc-geared-motor-with-encoder-collection-1.snapshot.3/Export/IGES/JGA25-371_12VDC_400RPM.igs
New folder/bringsmart-jga25-371-12v-dc-geared-motor-with-encoder-collection-1.snapshot.3/Export/IGES/JGA25-371_12VDC_50RPM.igs
New folder/bringsmart-jga25-371-12v-dc-geared-motor-with-encoder-collection-1.snapshot.3/Export/IGES/JGA25-371_12VDC_85RPM.igs
New folder/bringsmart-jga25-371-12v-dc-geared-motor-with-encoder-collection-1.snapshot.3/Export/IGES/JGA25-371_12VDC_915RPM.igs
New folder/bringsmart-jga25-371-12v-dc-geared-motor-with-encoder-collection-1.snapshot.3/JGA25-371_12VDC_110RPM.ipt
New folder/bringsmart-jga25-371-12v-dc-geared-motor-with-encoder-collection-1.snapshot.3/JGA25-371_12VDC_18RPM.ipt
New folder/bringsmart-jga25-371-12v-dc-geared-motor-with-encoder-collection-1.snapshot.3/JGA25-371_12VDC_190RPM.ipt
New folder/bringsmart-jga25-371-12v-dc-geared-motor-with-encoder-collection-1.snapshot.3/JGA25-371_12VDC_1930RPM.ipt
New folder/bringsmart-jga25-371-12v-dc-geared-motor-with-encoder-collection-1.snapshot.3/JGA25-371_12VDC_23RPM.ipt
New folder/bringsmart-jga25-371-12v-dc-geared-motor-with-encoder-collection-1.snapshot.3/JGA25-371_12VDC_250RPM.ipt
New folder/bringsmart-jga25-371-12v-dc-geared-motor-with-encoder-collection-1.snapshot.3/JGA25-371_12VDC_39RPM.ipt
New folder/bringsmart-jga25-371-12v-dc-geared-motor-with-encoder-collection-1.snapshot.3/JGA25-371_12VDC_400RPM.ipt
New folder/bringsmart-jga25-371-12v-dc-geared-motor-with-encoder-collection-1.snapshot.3/JGA25-371_12VDC_50RPM.ipt
New folder/bringsmart-jga25-371-12v-dc-geared-motor-with-encoder-collection-1.snapshot.3/JGA25-371_12VDC_85RPM.ipt
New folder/bringsmart-jga25-371-12v-dc-geared-motor-with-encoder-collection-1.snapshot.3/JGA25-371_12VDC_915RPM.ipt
New folder/e_drawing/37 mm DC Geared Motor Mounting Bracket.SLDDRW
New folder/e_drawing/battery.SLDDRW
New folder/e_drawing/blue_wheel_frame_Default_sldprt.step.SLDDRW
configurable-rc-coupling-1.snapshot.7/Conversions/RC coupling.IGS
configurable-rc-coupling-1.snapshot.7/Conversions/RC coupling.STL
configurable-rc-coupling-1.snapshot.7/Conversions/RC coupling.x_t
motor_shaft_coupling_v2.SLDPRT
