hoangwe/Computation-design-fabrication-and-control-of-a-Two-wheel-Balancing-Robot./New folder/New folder/Part0_loc.pdf

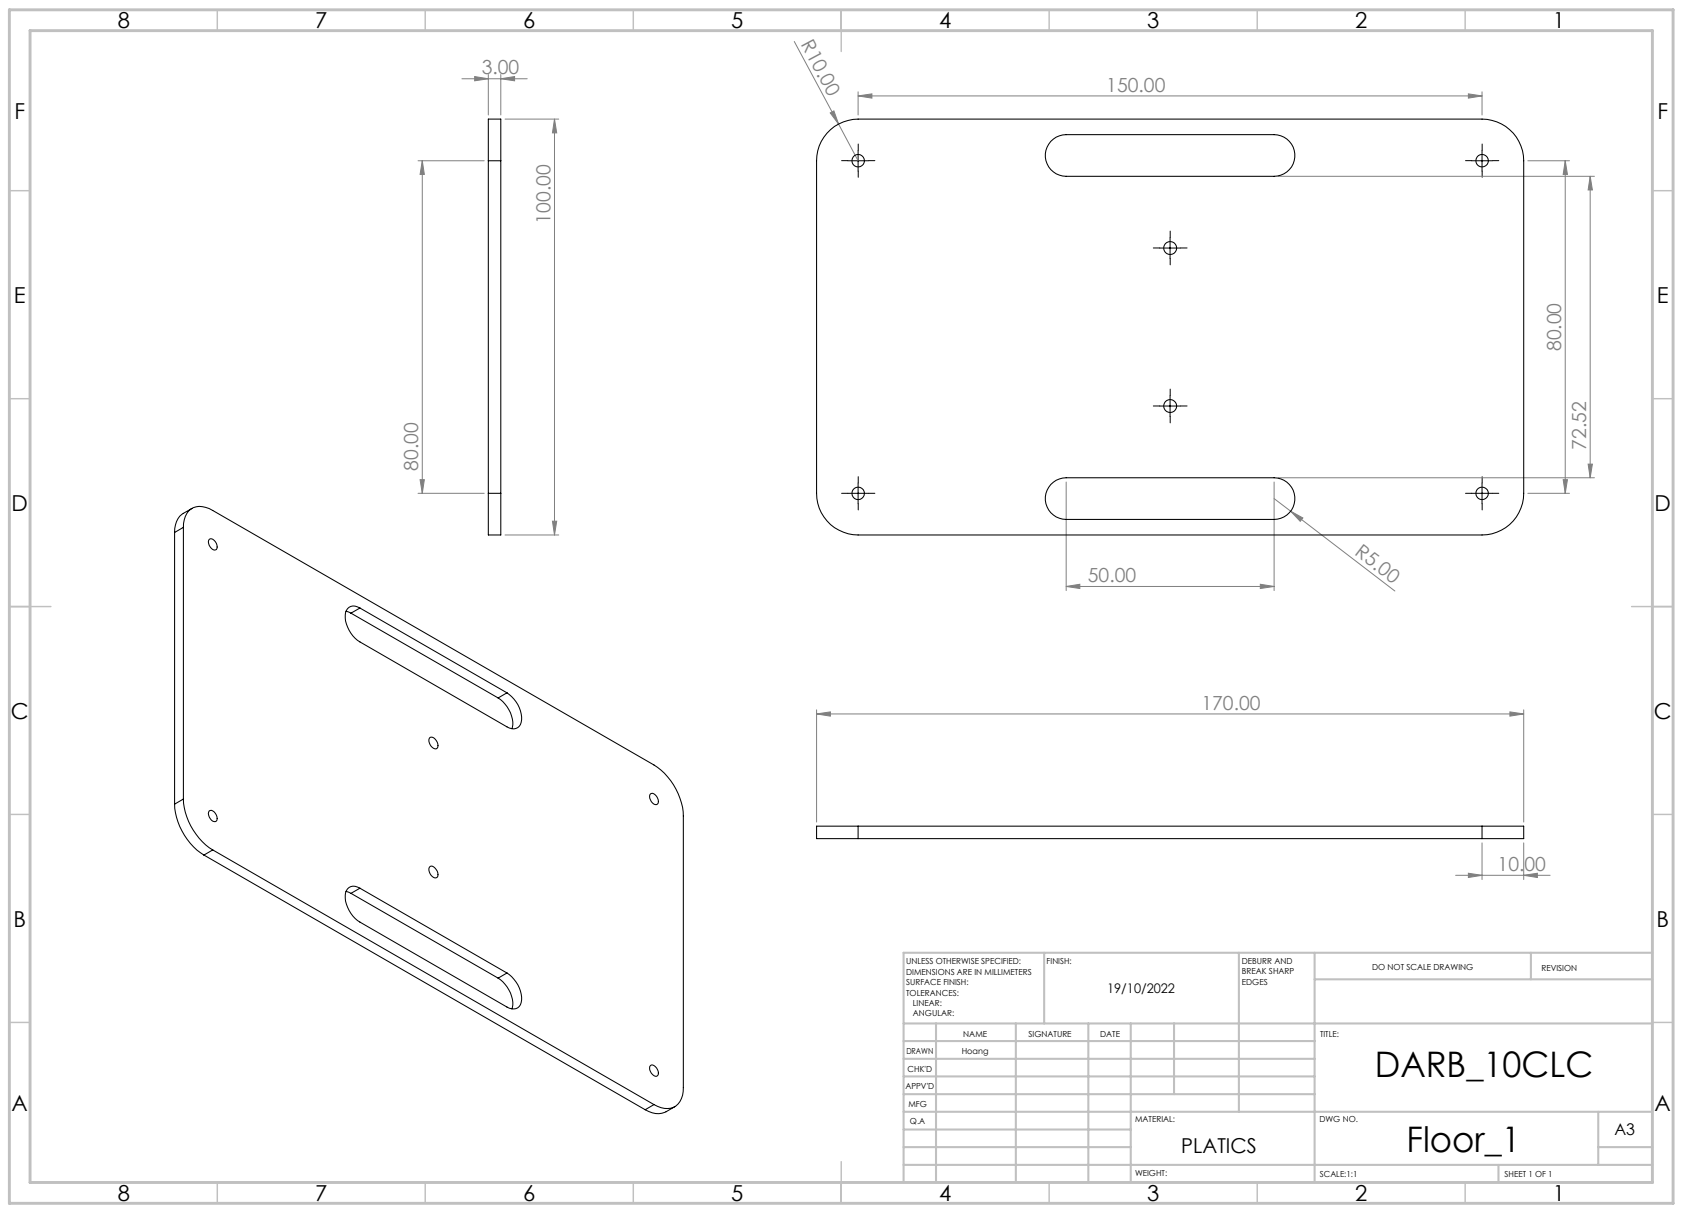
[picture p237: page 1]
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

UNLESS OTHERWISE SPECIFIED:
DIMENSIONS ARE IN MILLIMETERS
SURFACE FINISH:
TOLERANCES:
LINEAR:
ANGULAR:

NAME | SIGNATURE | DATE | | | | TITLE: DARB_10CLC

DRAWN | Hoang
CHK'D
APPV'D
MFG
Q.A | | | | MATERIAL: PLATICS | DWG NO. Floor_1 | A3
