hoangwe/Computation-design-fabrication-and-control-of-a-Two-wheel-Balancing-Robot./New folder/New folder/New folder/New folder/file_dwg/37 mm DC Geared Motor Mounting Bracket.pdf

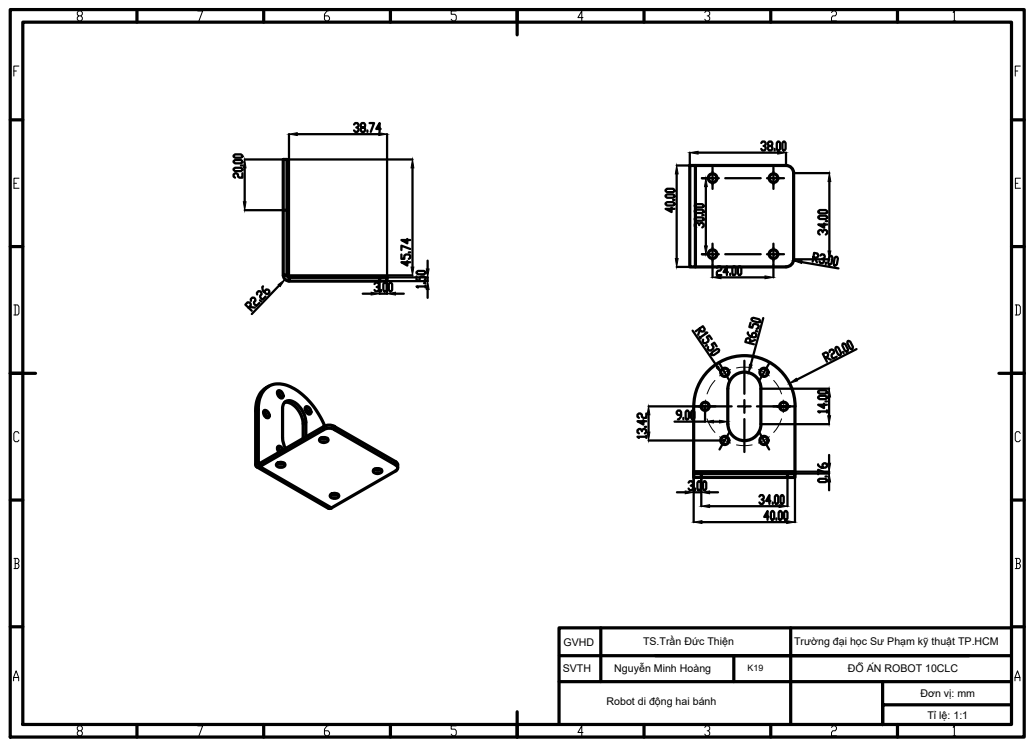
[picture p238: page 1]
TS.Trần Đức Thiện Nguyễn Minh Hoàng; K19 Robot di động hai bánh; Trường đại học Sư Phạm kỹ thuật TP.HCM

SVTH

GVHD

Tỉ lệ: 1:1 ĐỒ ÁN ROBOT 10CLC Đơn vị: mm
