hoangwe/Computation-design-fabrication-and-control-of-a-Two-wheel-Balancing-Robot./New folder/New folder/New folder/New folder/file_dwg/Part0_loc.pdf

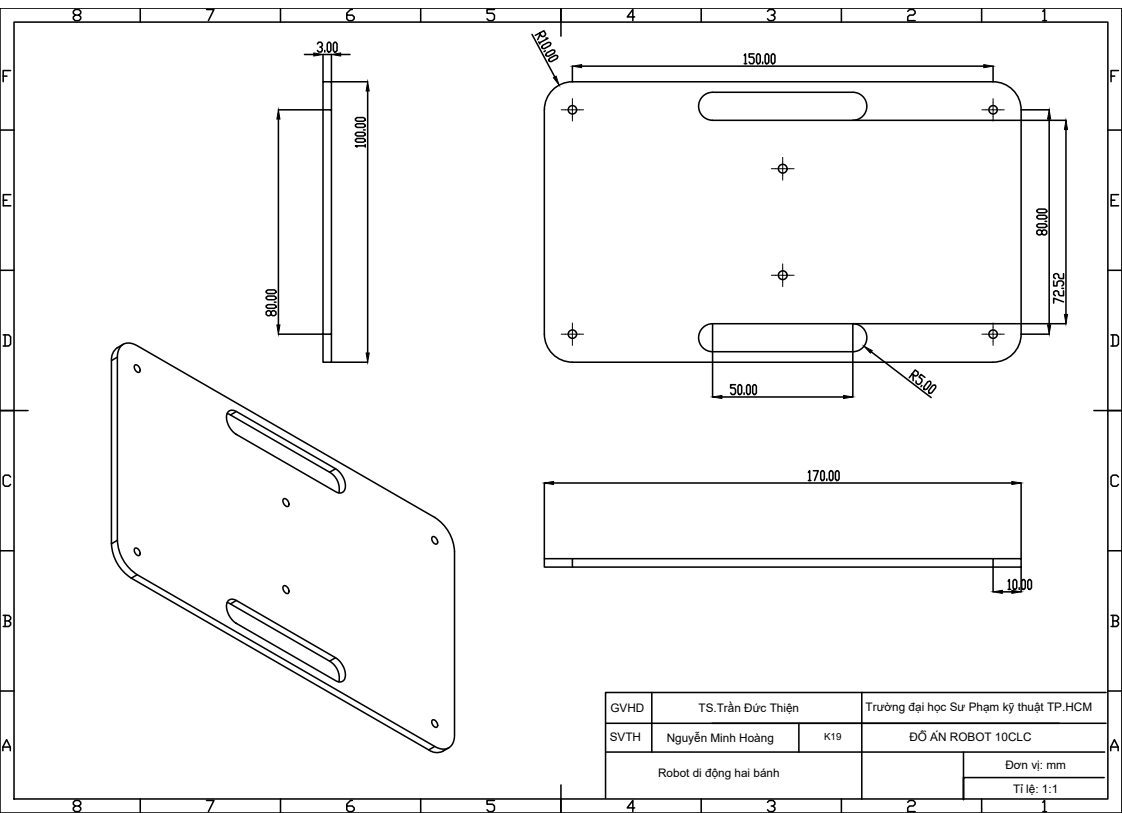
[picture p239: page 1]

GVHD | TS.Trần Đức Thiện | Trường đại học Sư Phạm kỹ thuật TP.HCM

SVTH | Nguyễn Minh Hoàng | K19 Robot di động hai bánh | ĐỒ ÁN ROBOT 10CLC

Đơn vị: mm Tỉ lệ: 1:1
