hoangwe/Computation-design-fabrication-and-control-of-a-Two-wheel-Balancing-Robot./New folder/New folder/New folder/New folder/file_dwg/Part3_loc.pdf

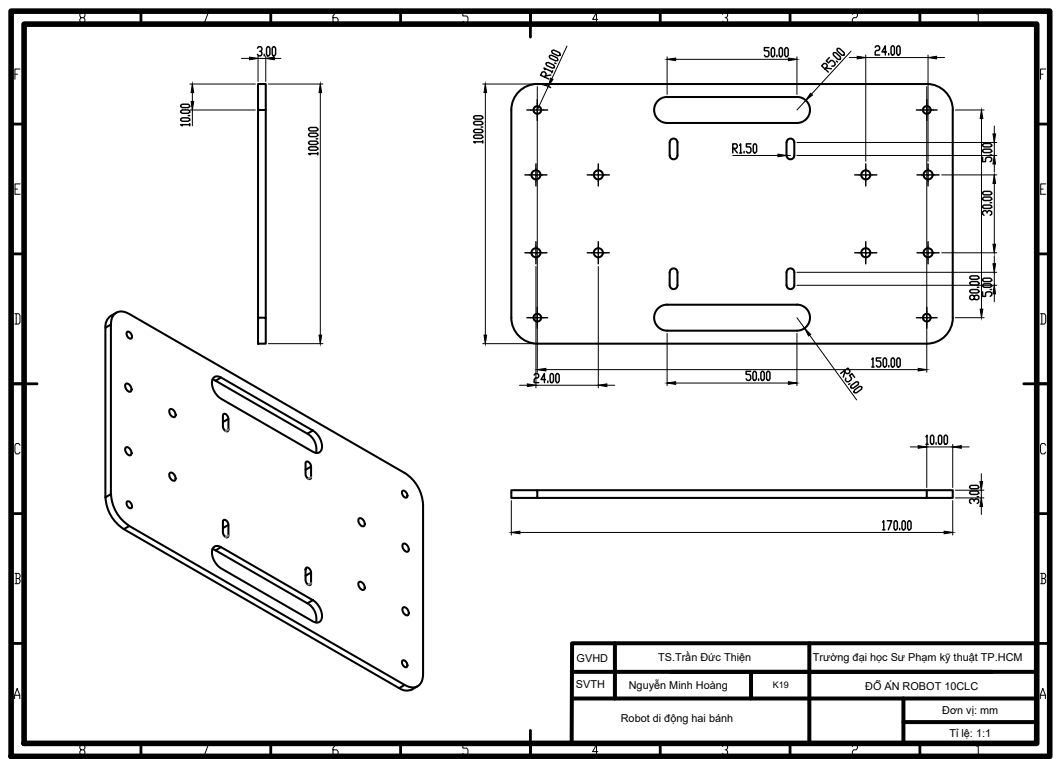
[picture p240: page 1]
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

GVHD

SVTH

Tỉ lệ: 1:1 ĐỒ ÁN ROBOT 10CLC Đơn vị: mm
